murrayinglis/EEE4113F-Group19/Housing/Pictures/Final Design in E drawing exploded View.png

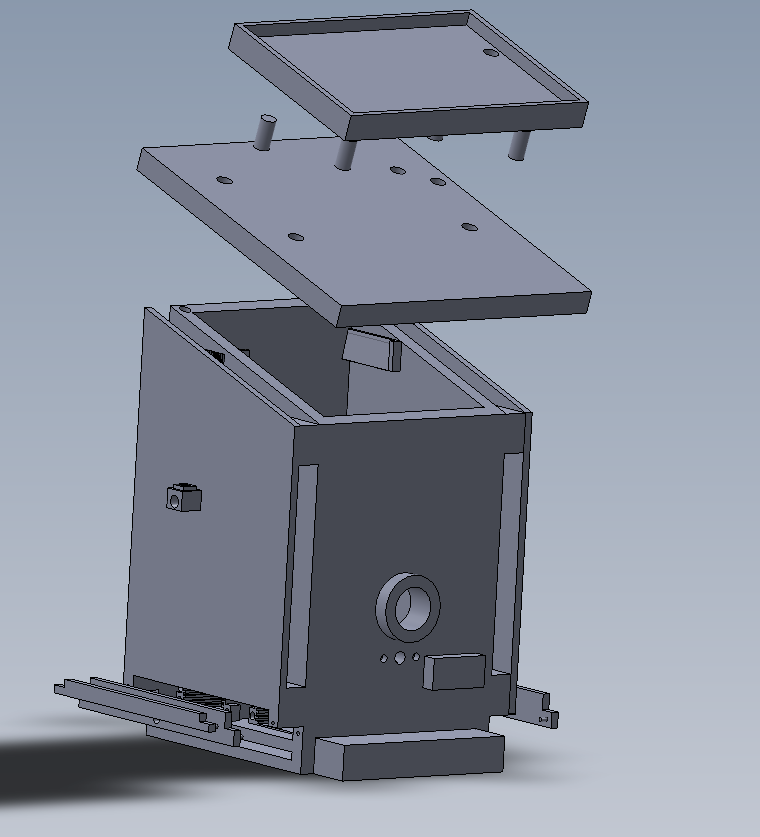
Housing/Pictures/Final Design in E drawing exploded View.png
