murrayinglis/EEE4113F-Group19/Housing/Pictures/Final Design/20240512_164723.jpg

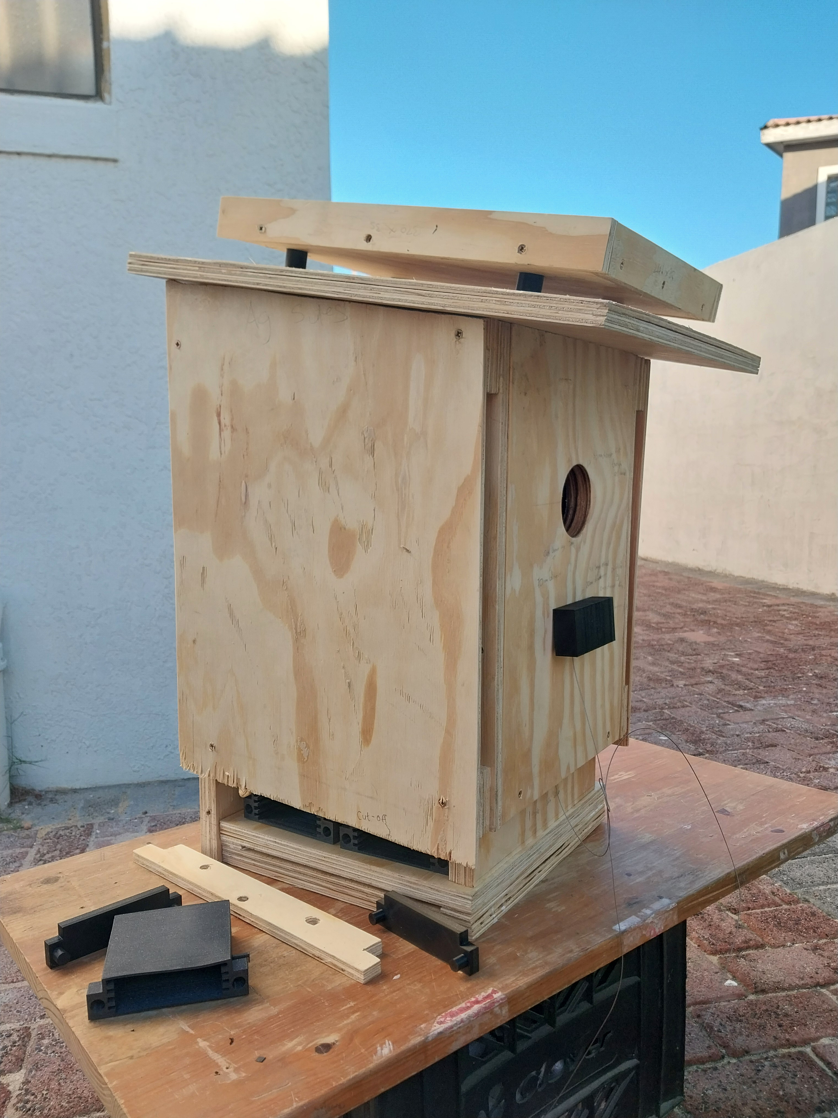
Housing/Pictures/Final Design/20240512_164723.jpg
