murrayinglis/EEE4113F-Group19/README.md

# EEE4113F Group 19 Project
This project concerns the development of a temperature sensing system. There are 4 subsystems: Power, GUI, Sensing and Housing. This repository contains the resources used to complete the project.
