murrayinglis/EEE4113F-Group19/Docs/Requirements Specifications.docx

Requirements:

Microcontroller + sensing:

Power:

Physical design:


UI:
