murrayinglis/EEE4113F-Group19/Docs/Lit Review Sources.docx

Lit Review Sources

https://open.uct.ac.za/server/api/core/bitstreams/53c4703e-6efa-4478-9e95-13aa0d085189/content

High Ta during the nesting period had a negative effect on the outcomes of hornbill breeding attempts. Page 85

https://www.researchgate.net/profile/Soon-Chye-Ng/publication/242690746_Infanticide-cannibalism_in_the_Oriental_Pied_Hornbill_Anthracoceros_albirostris/links/0046353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

infanticide-cannibalism

https://link.springer.com/article/10.1186/s40317-015-0075-2

Rectal or cloacal temperature is commonly measured using thermometry

https://www-ncbi-nlm-nih-gov.ezproxy.uct.ac.za/pmc/articles/PMC5723608/

Our search of 18 years of literature (1998–2015) in 20 target ecology journals identified a total of 185 papers that used iButtons

https://onlinelibrary-wiley-com.ezproxy.uct.ac.za/doi/full/10.1111/ibi.12010

Thermal imaging can be a valuable tool to examine energy expenditure

As yet, this technique has not been widely used

https://www-ncbi-nlm-nih-gov.ezproxy.uct.ac.za/pmc/articles/PMC6476170/

we experienced a 65% failure rate of iButton Hygrochrons after a one‐year deployment

comms stuff:

https://www-sciencedirect-com.ezproxy.uct.ac.za/science/article/pii/S095741742303364X?via%3Dihub

Communication between the smart node in our project and the IoT is established via Cytron 915 MHz LoRa RFM shield, which allows data to be wirelessly transmitted over a long distance at low data rates (<50 kbps)

https://www-sciencedirect-com.ezproxy.uct.ac.za/science/article/pii/S0957417422019947?via%3Dihub

https://ieeexplore-ieee-org.ezproxy.uct.ac.za/document/1367928

https://www-sciencedirect-com.ezproxy.uct.ac.za/science/article/pii/S0165027019301037?via%3Dihub
