murrayinglis/EEE4113F-Group19/Docs/lorawan.jpg

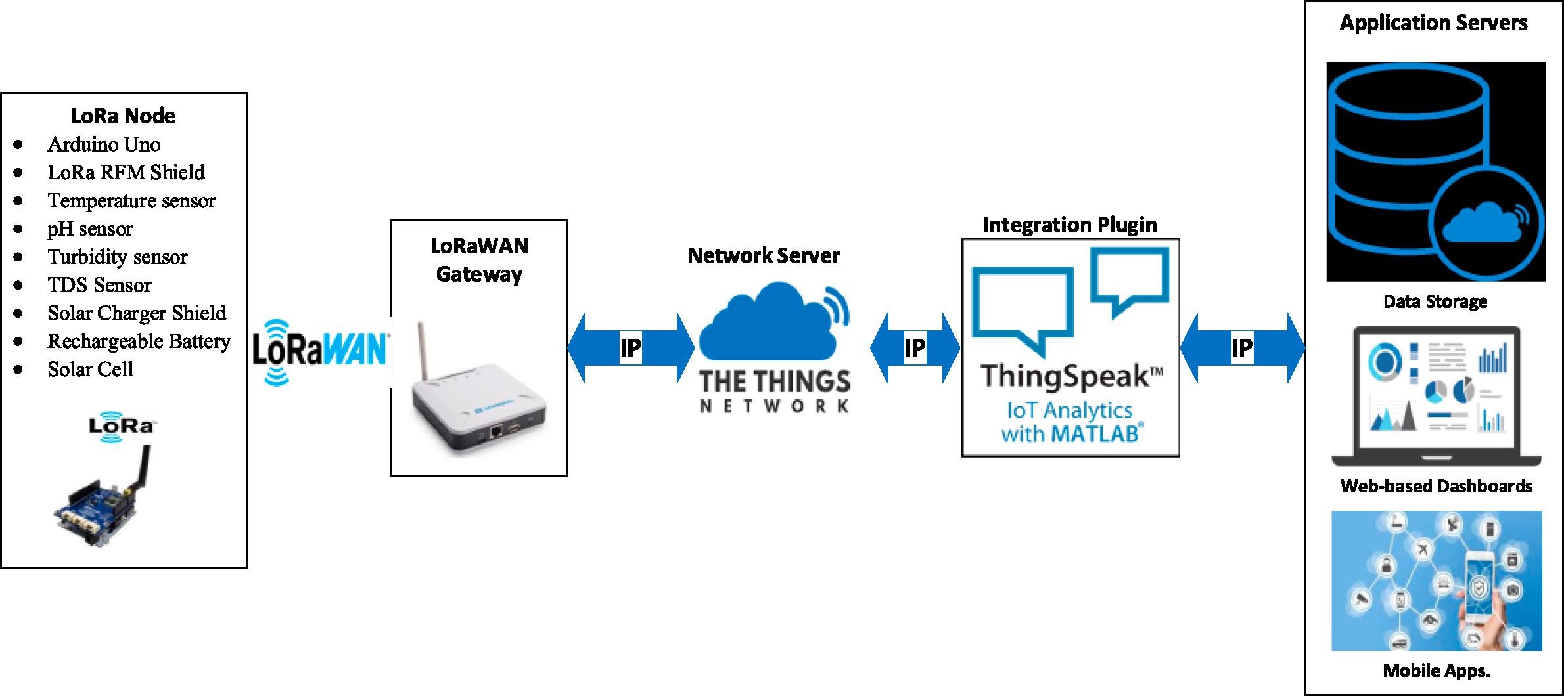
Docs/lorawan.jpg
