murrayinglis/EEE4113F-Group19/Figures/antenna.png

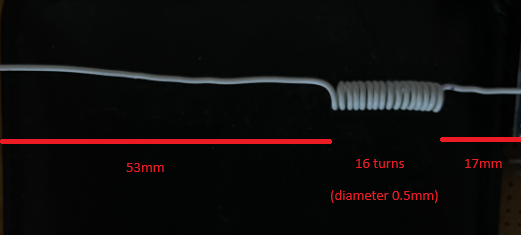
Figures/antenna.png
