murrayinglis/EEE4113F-Group19/Figures/ds18b20.png

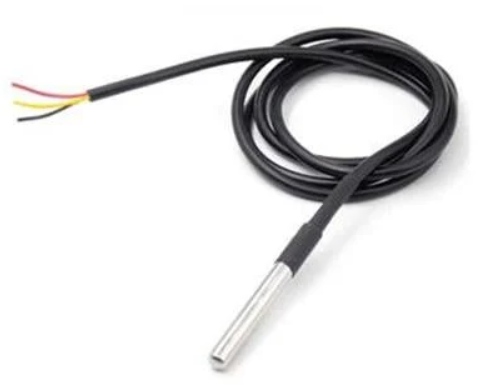
Figures/ds18b20.png
