murrayinglis/EEE4113F-Group19/Figures/receiver.drawio.png

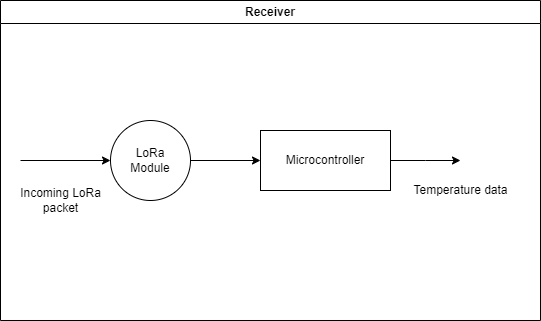
Figures/receiver.drawio.png
