murrayinglis/EEE4113F-Group19/Figures/receiver.png

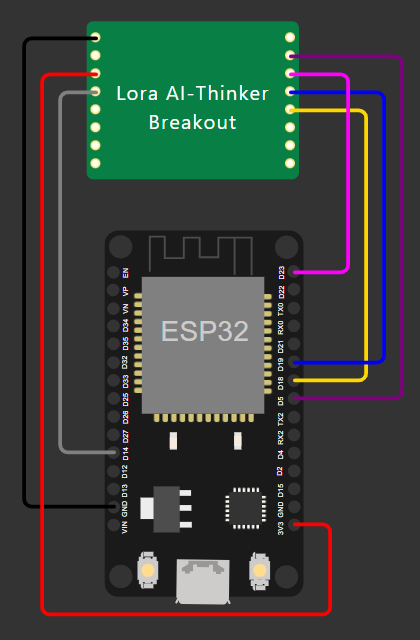
Figures/receiver.png
