murrayinglis/EEE4113F-Group19/Figures/receiver_veroboard.png

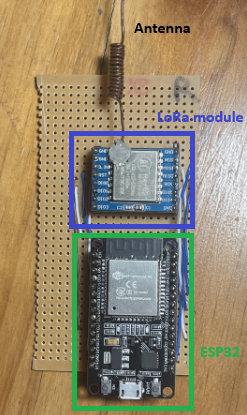
Figures/receiver_veroboard.png
