murrayinglis/EEE4113F-Group19/Figures/state_machine.drawio.png

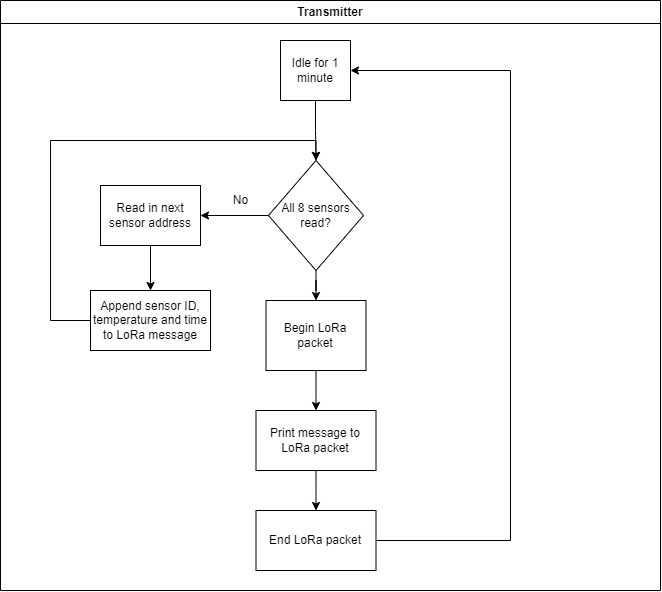
Figures/state_machine.drawio.png
