murrayinglis/EEE4113F-Group19/Figures/transmitter.png

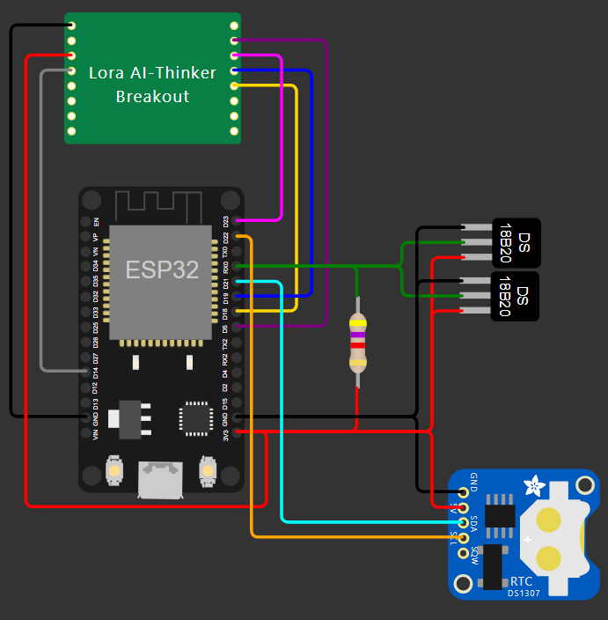
Figures/transmitter.png
