murrayinglis/EEE4113F-Group19/Figures/transmitter_veroboard.png

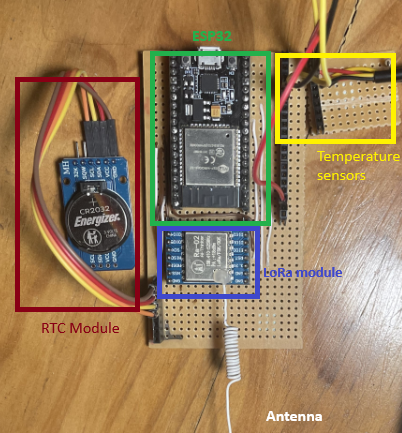
Figures/transmitter_veroboard.png
