murrayinglis/EEE4113F-Group19/Figures/trasnmitter.drawio.png

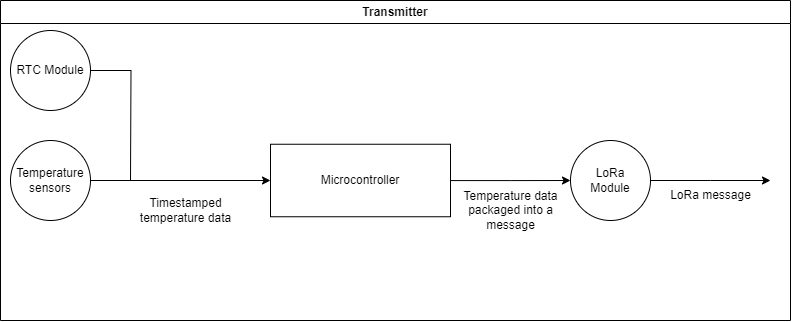
Figures/trasnmitter.drawio.png
