murrayinglis/EEE4113F-Group19/Housing/Pictures/Air gap increasing distance.png

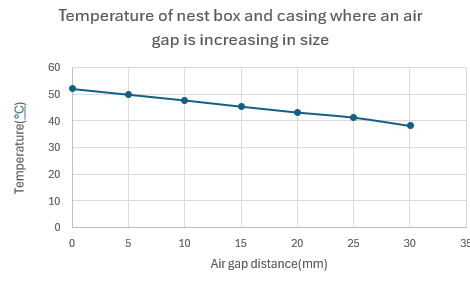
Housing/Pictures/Air gap increasing distance.png
