murrayinglis/EEE4113F-Group19/Housing/Pictures/Design box .png

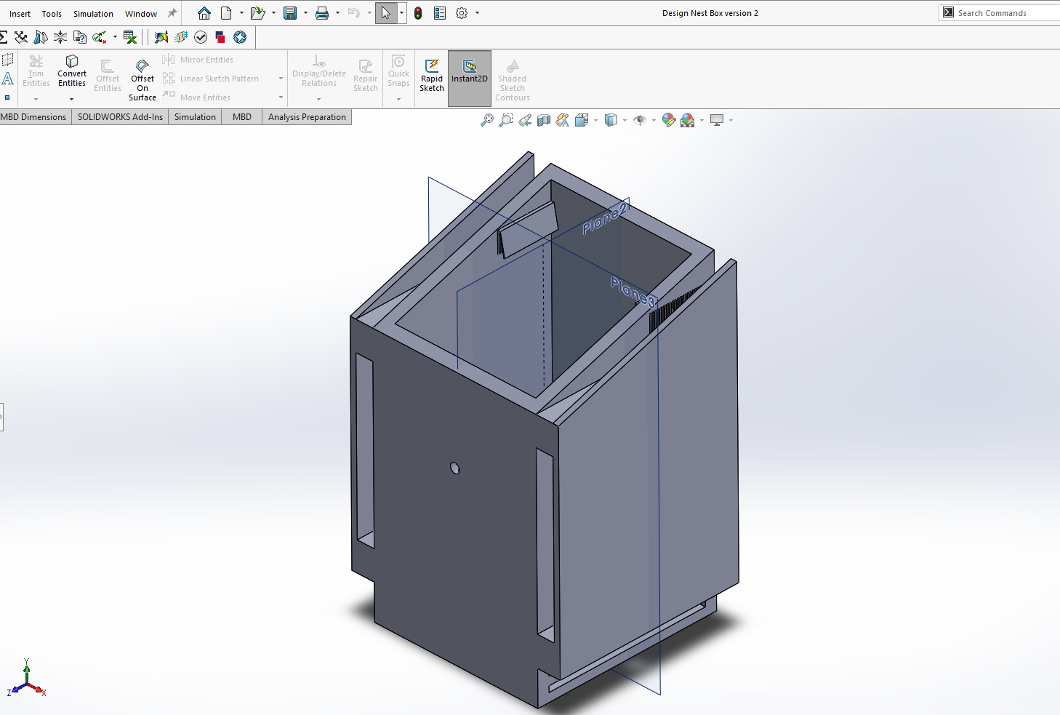
Housing/Pictures/Design box .png
