murrayinglis/EEE4113F-Group19/Housing/Pictures/Design box side profile.png

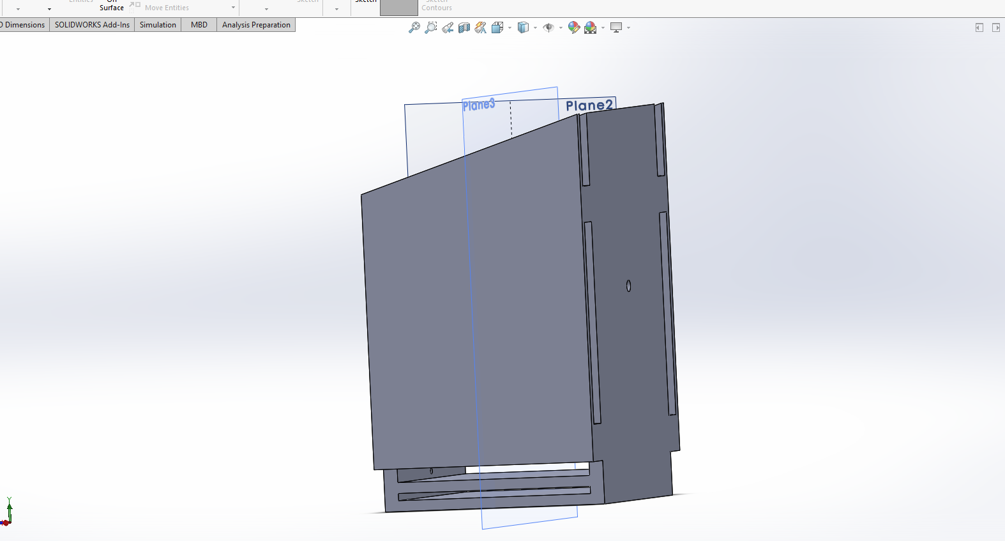
Housing/Pictures/Design box side profile.png
