murrayinglis/EEE4113F-Group19/Housing/Pictures/Diameter graph.png

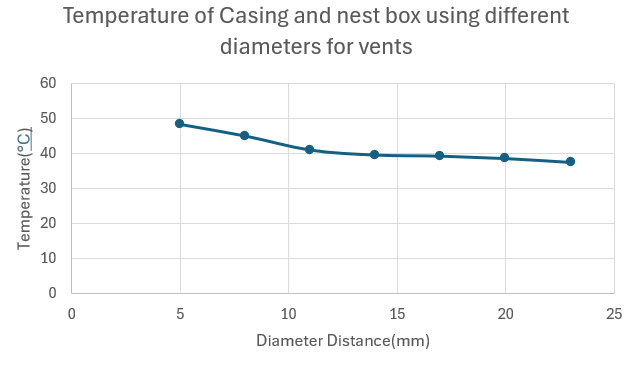
Housing/Pictures/Diameter graph.png
