murrayinglis/EEE4113F-Group19/Housing/Pictures/Displacement.png

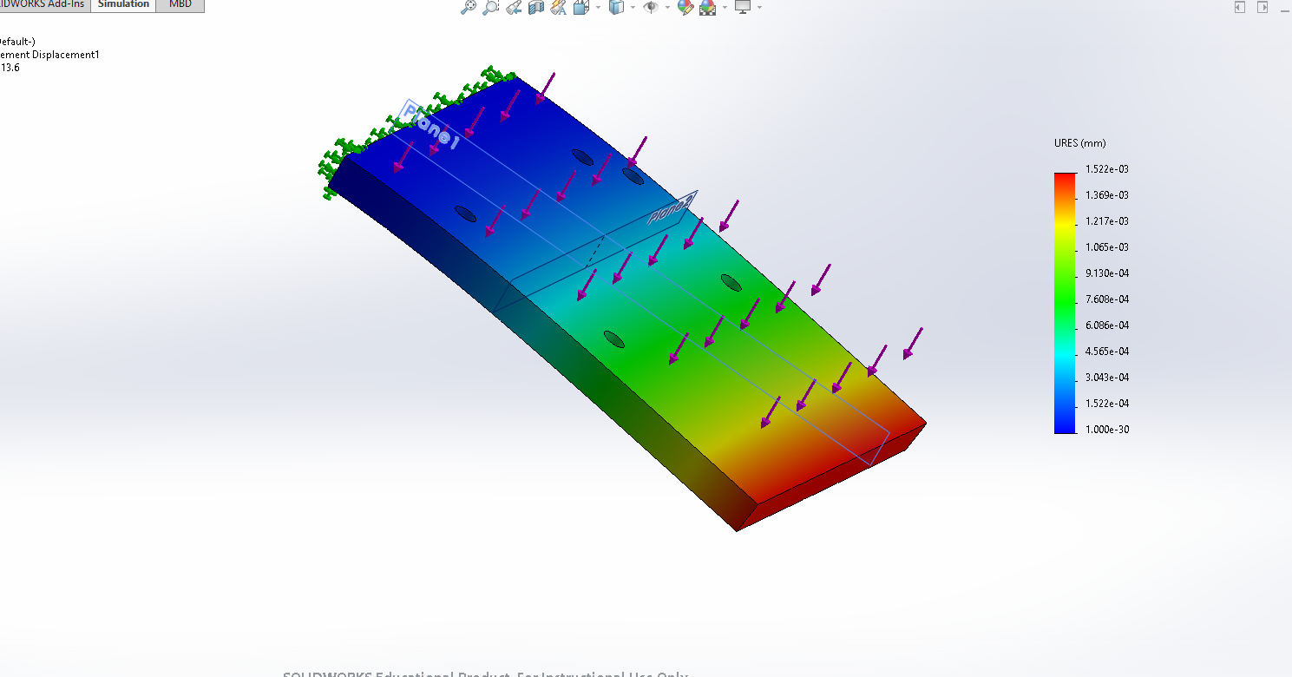
Housing/Pictures/Displacement.png
