murrayinglis/EEE4113F-Group19/Housing/Pictures/Drawing of Tepreture sensor holder.png

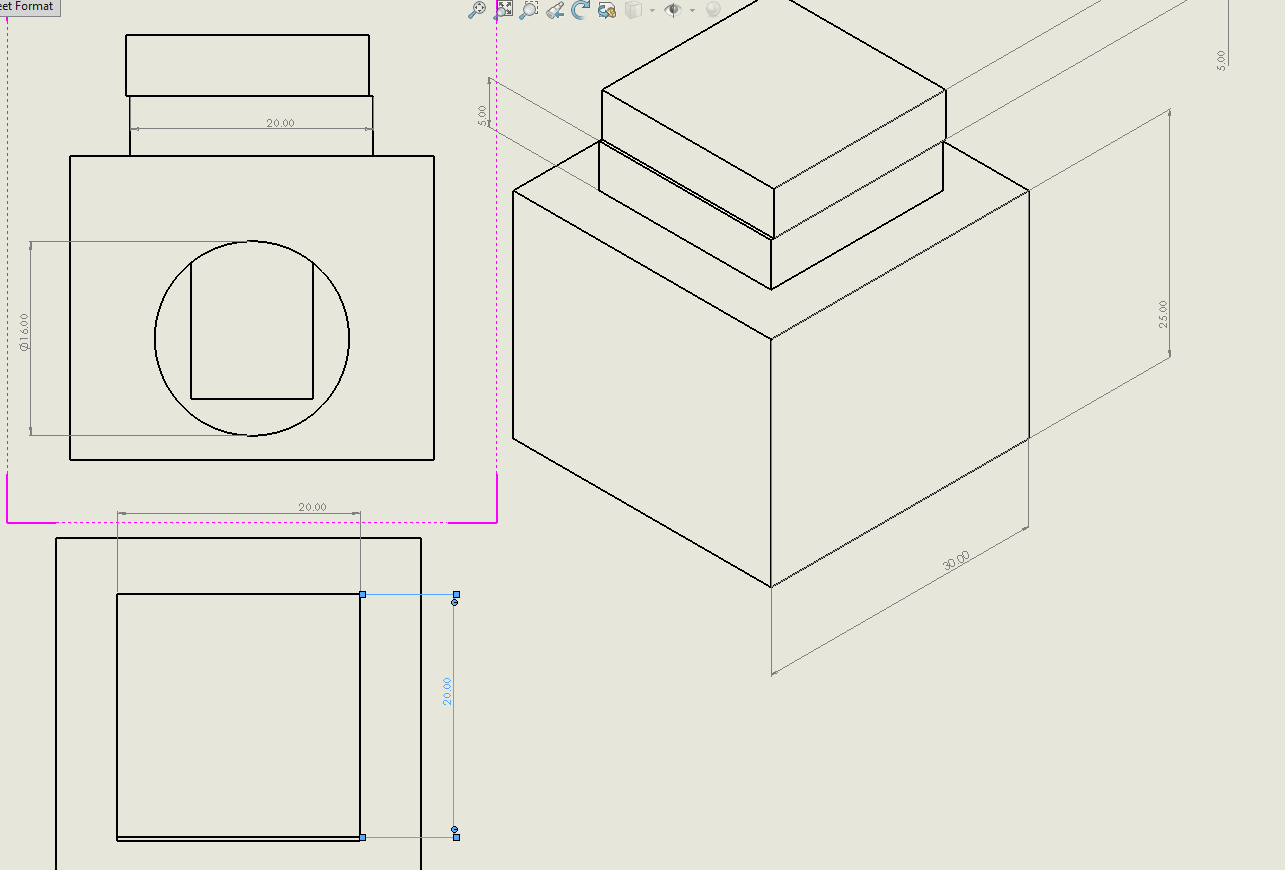
Housing/Pictures/Drawing of Tepreture sensor holder.png
