murrayinglis/EEE4113F-Group19/Housing/Pictures/Drawings for Enclosure Box.png

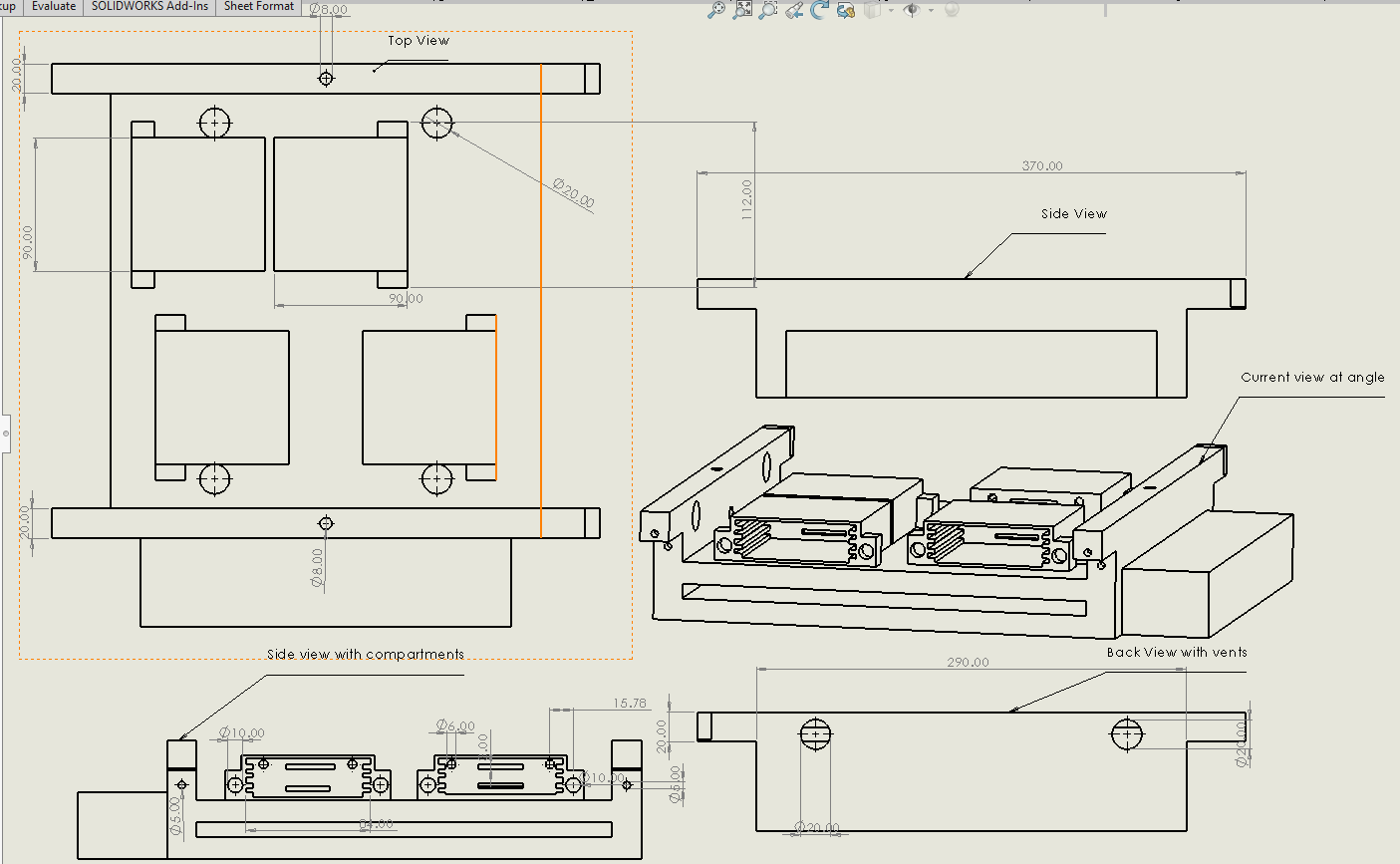
Housing/Pictures/Drawings for Enclosure Box.png
