murrayinglis/EEE4113F-Group19/Housing/Pictures/Electronics Compartment with another air gap for thermal mass below it.png

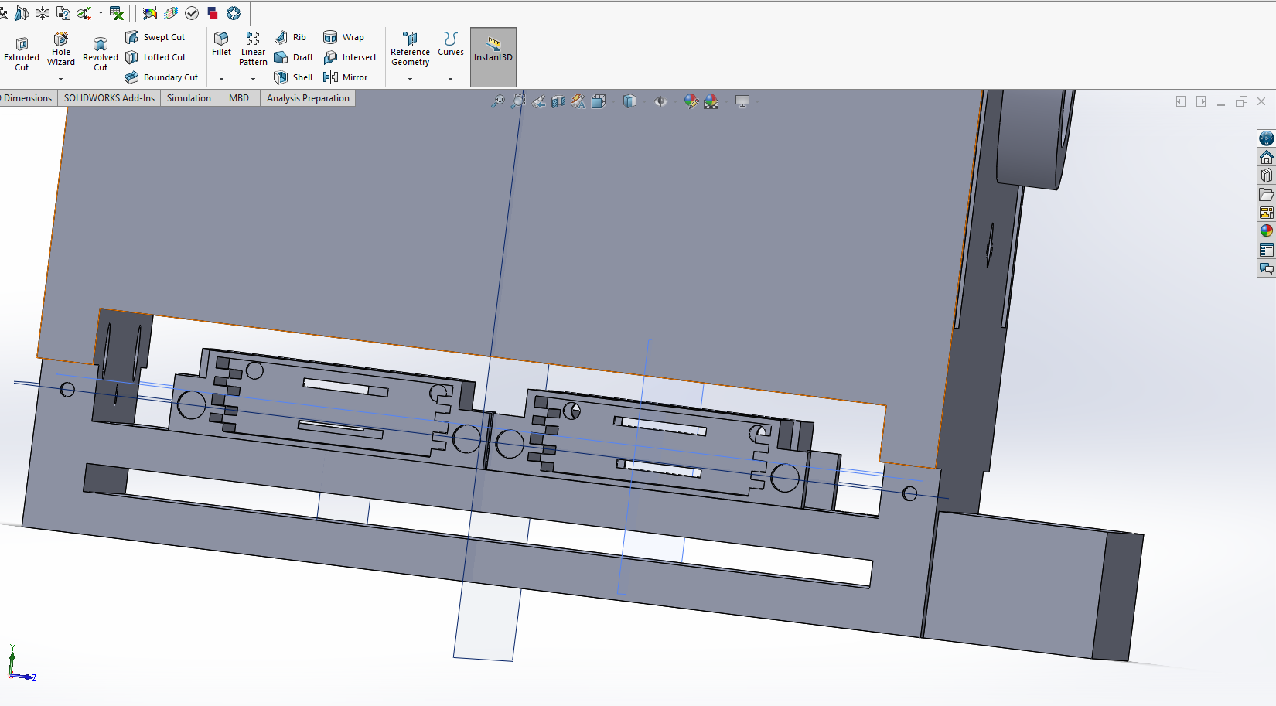
Housing/Pictures/Electronics Compartment with another air gap for thermal mass below it.png
