murrayinglis/EEE4113F-Group19/Housing/Pictures/Enclosure section viewed.png

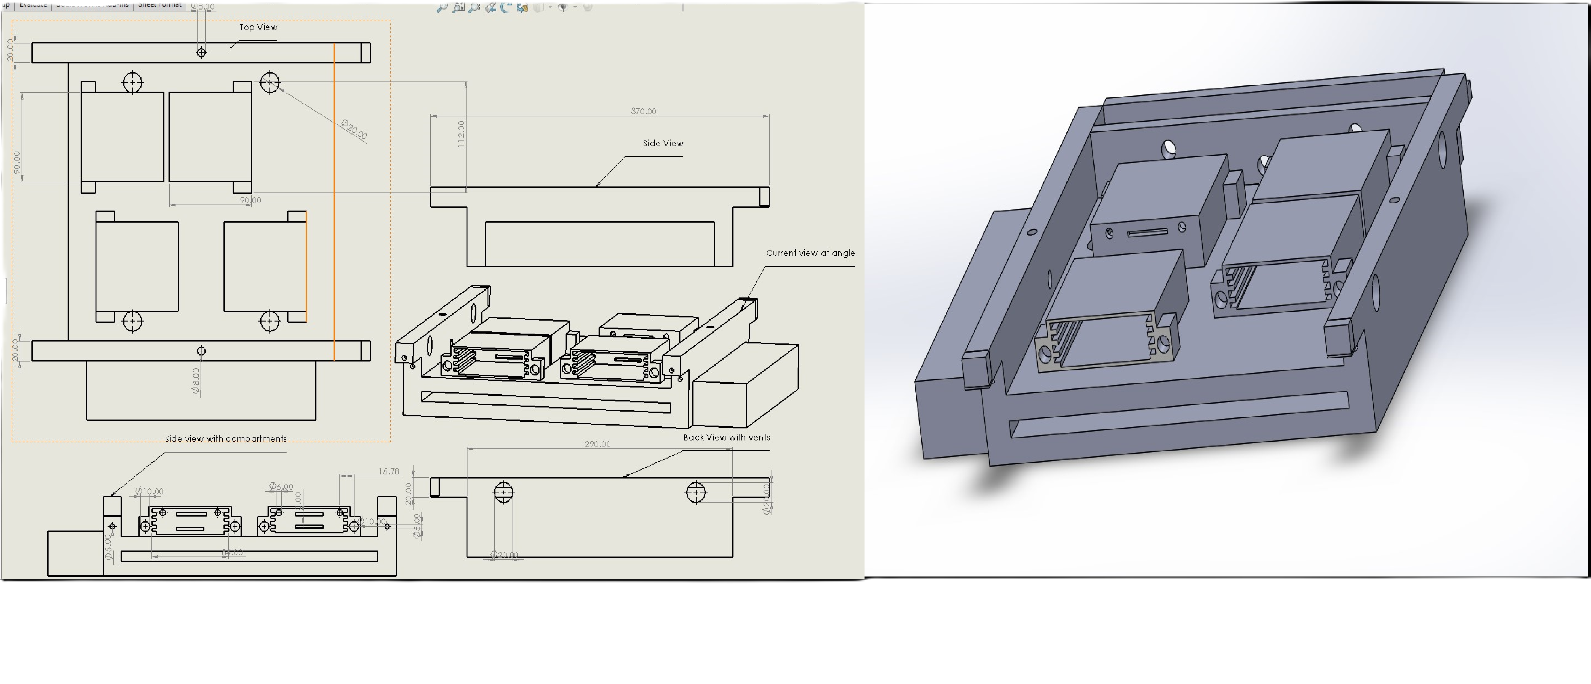
Housing/Pictures/Enclosure section viewed.png
