murrayinglis/EEE4113F-Group19/Housing/Pictures/Exploded View/Screenshot_20240511_043744_Samsung Notes.jpg

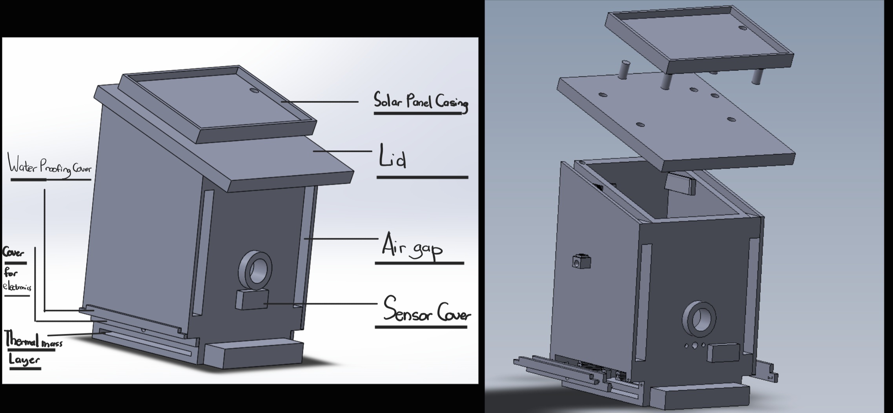
Housing/Pictures/Exploded View/Screenshot_20240511_043744_Samsung Notes.jpg
