murrayinglis/EEE4113F-Group19/Housing/Pictures/Exploded View/Screenshot_20240511_044054_Samsung Notes.jpg

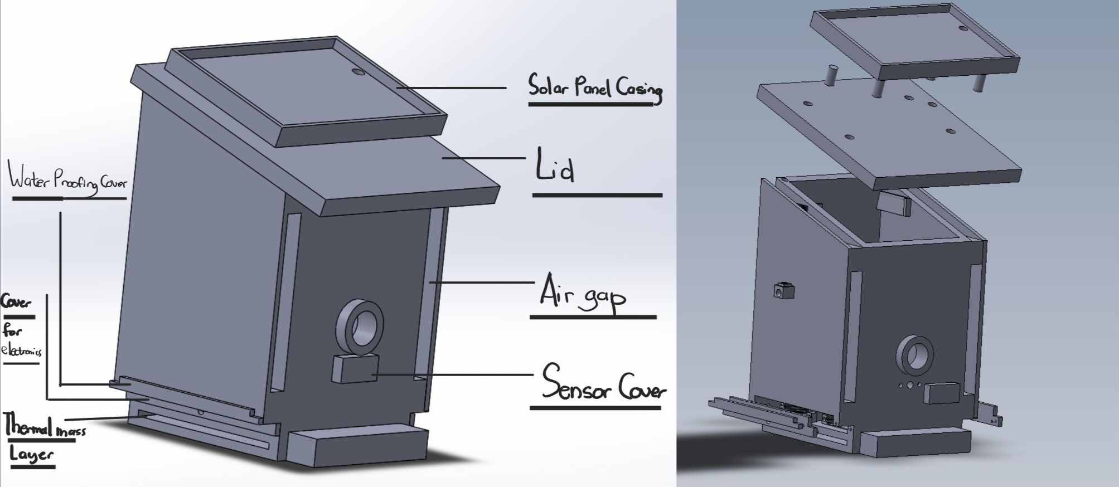
Housing/Pictures/Exploded View/Screenshot_20240511_044054_Samsung Notes.jpg
