murrayinglis/EEE4113F-Group19/Housing/Pictures/Extra coverings and Temp sensor casings.png

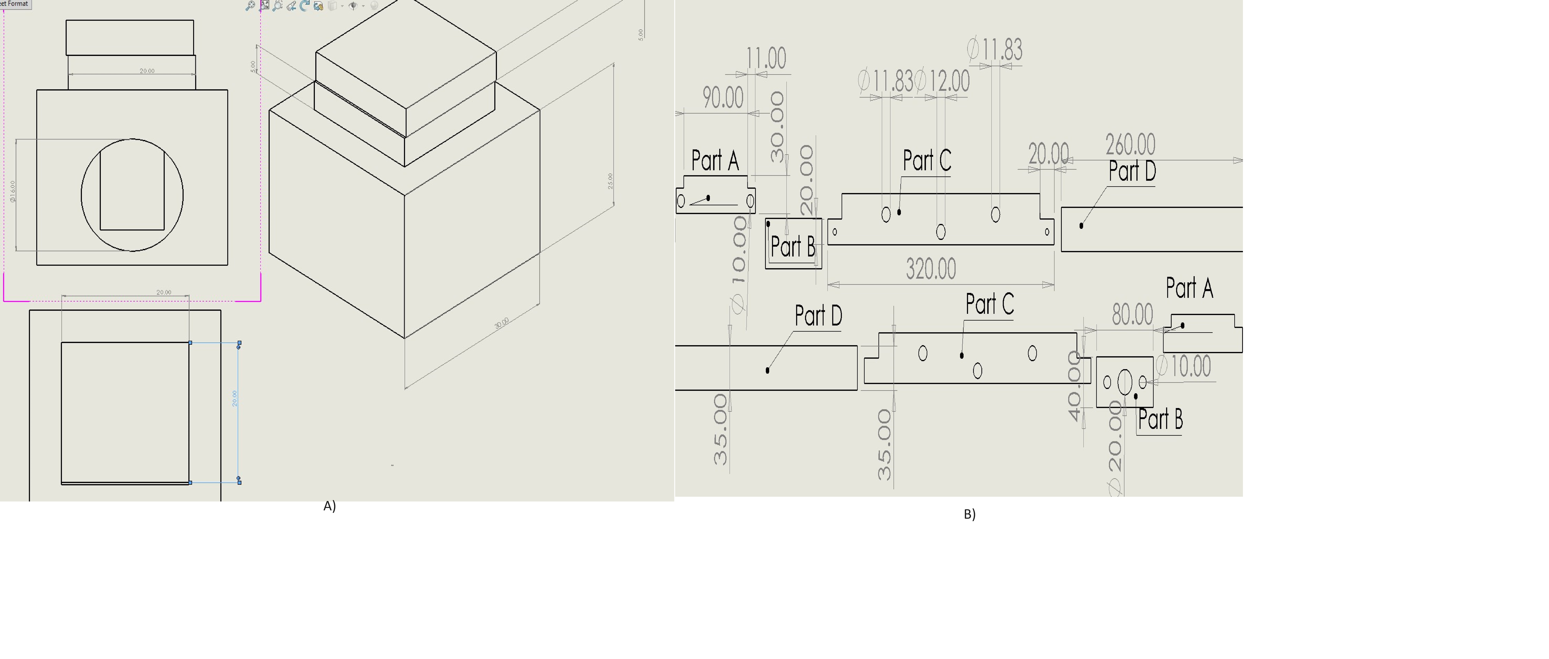
Housing/Pictures/Extra coverings and Temp sensor casings.png
