murrayinglis/EEE4113F-Group19/Housing/Pictures/Final Design of Nest box .png

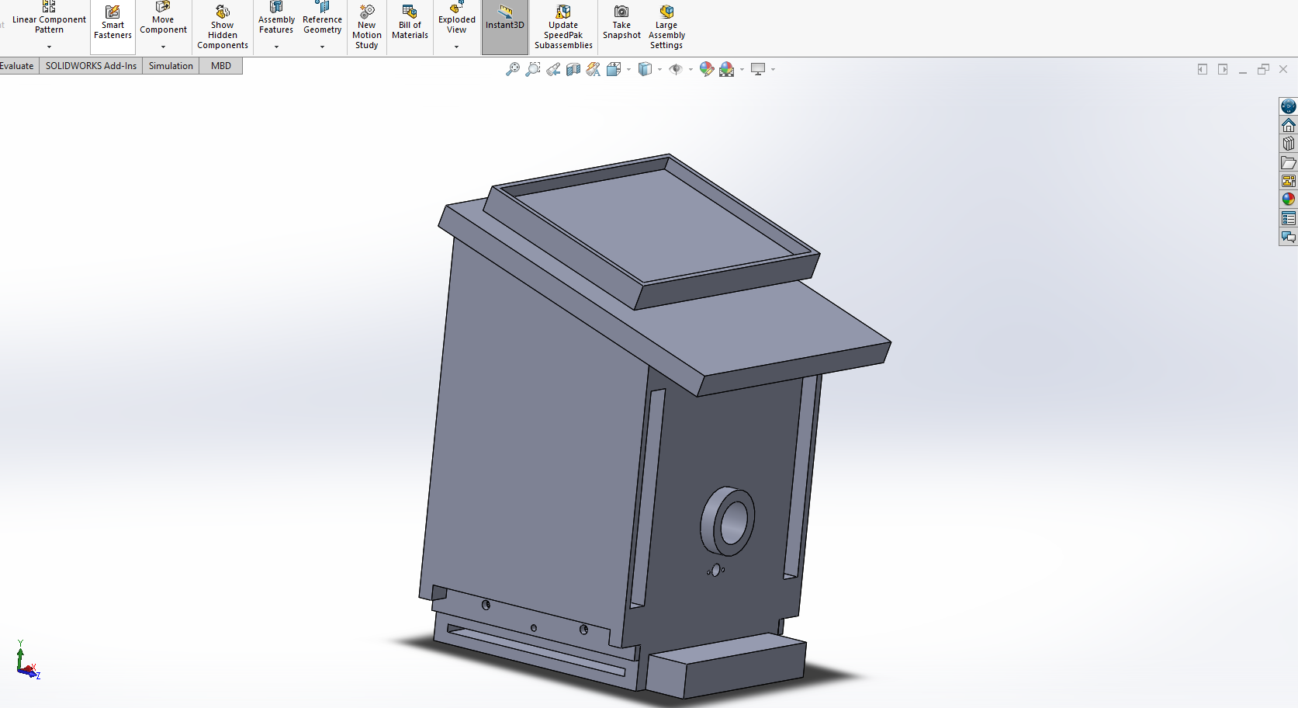
Housing/Pictures/Final Design of Nest box .png
