murrayinglis/EEE4113F-Group19/Housing/Pictures/Final final Design of nest box.png

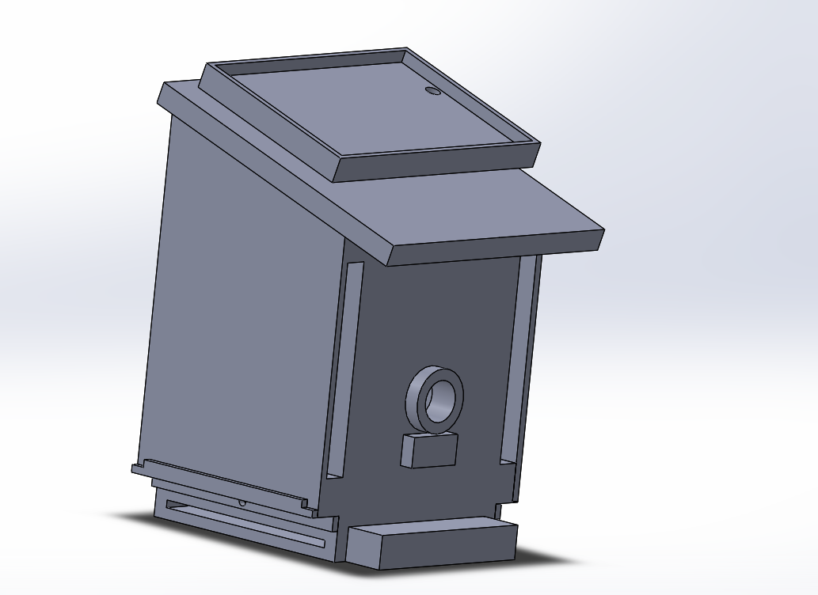
Housing/Pictures/Final final Design of nest box.png
