murrayinglis/EEE4113F-Group19/Housing/Pictures/Final temp lid and coverings.png

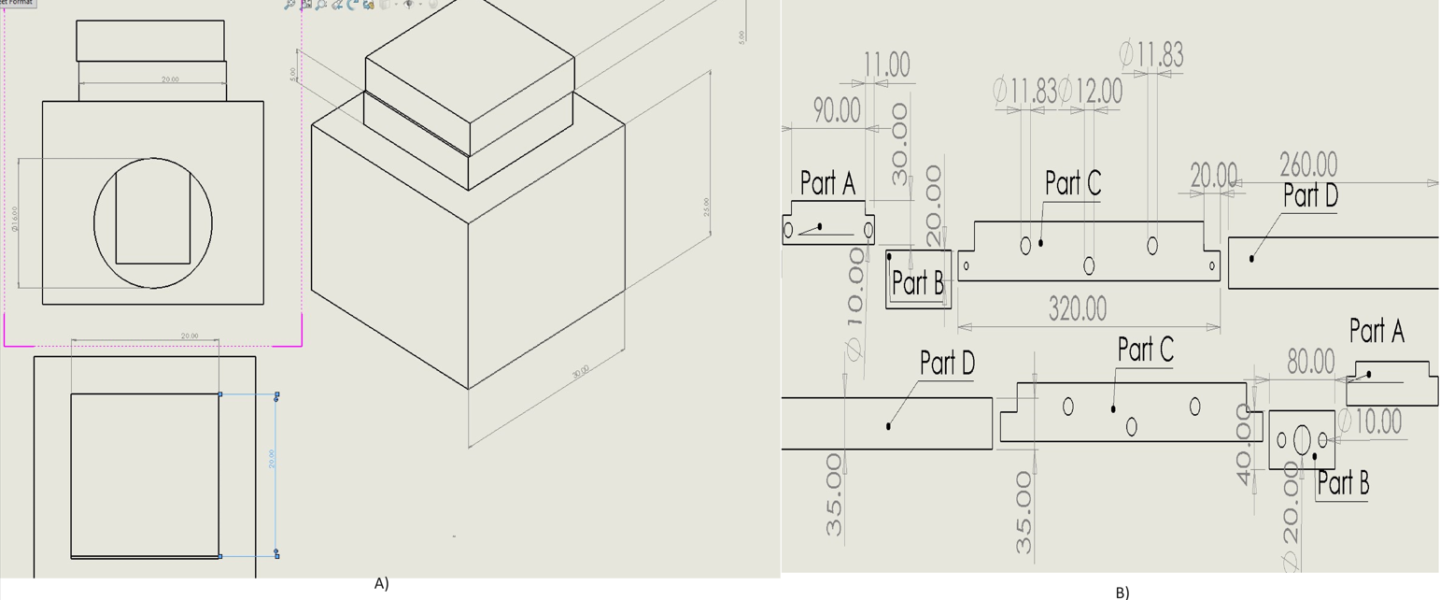
Housing/Pictures/Final temp lid and coverings.png
