murrayinglis/EEE4113F-Group19/Housing/Pictures/Housing of Electrical compartments.png

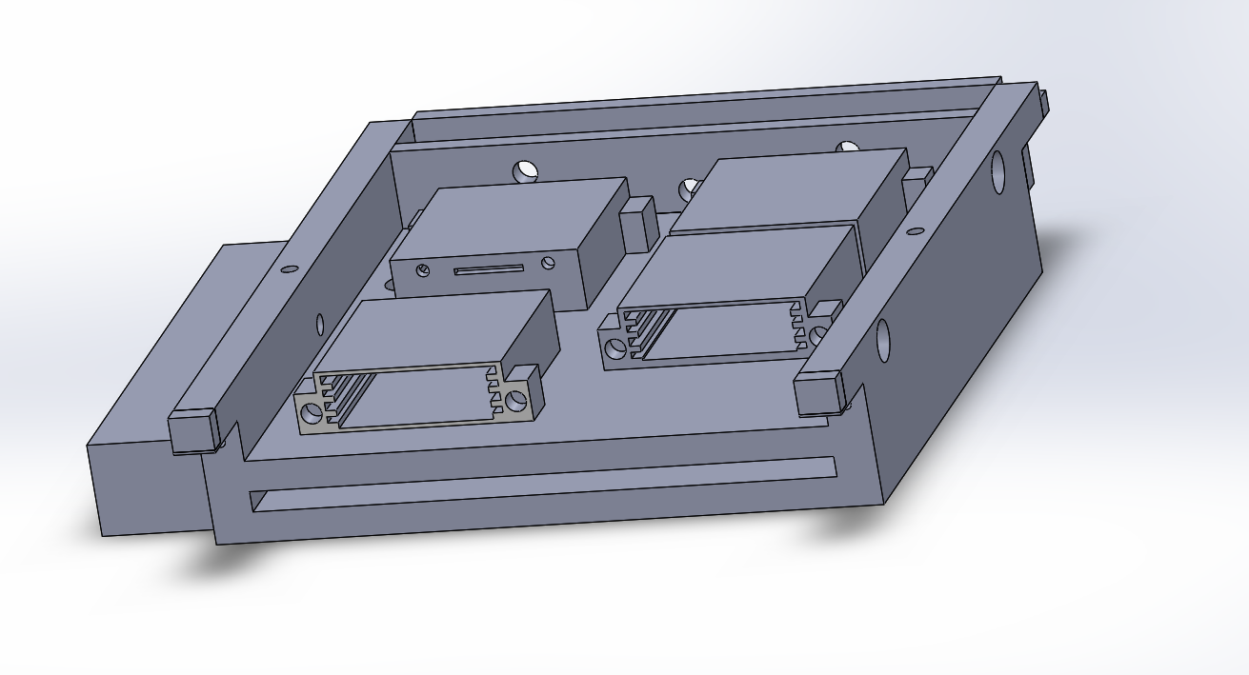
Housing/Pictures/Housing of Electrical compartments.png
