murrayinglis/EEE4113F-Group19/Housing/Pictures/Lid and Enclosure stress analysis.jpg

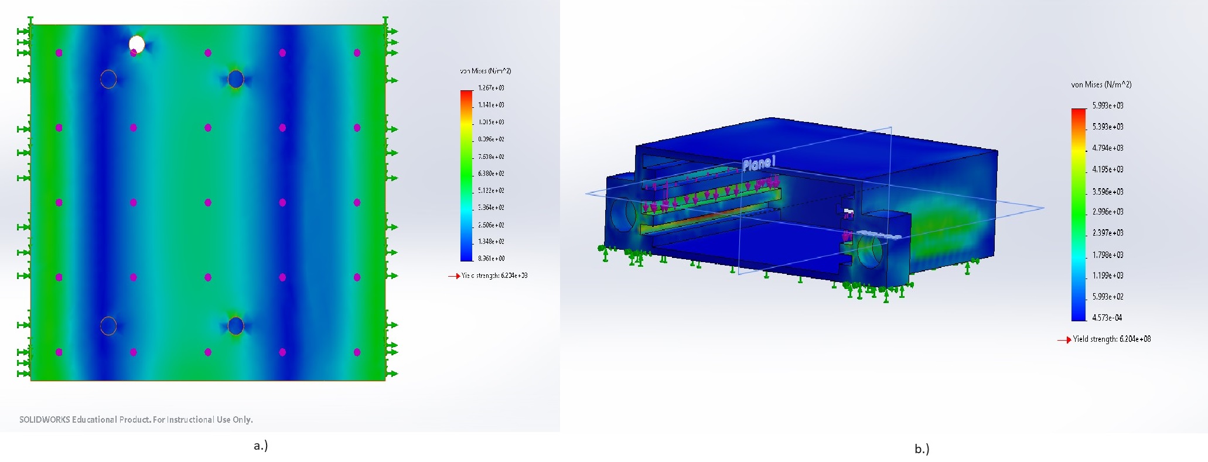
Housing/Pictures/Lid and Enclosure stress analysis.jpg
