murrayinglis/EEE4113F-Group19/Housing/Pictures/Lid stress analysis.png

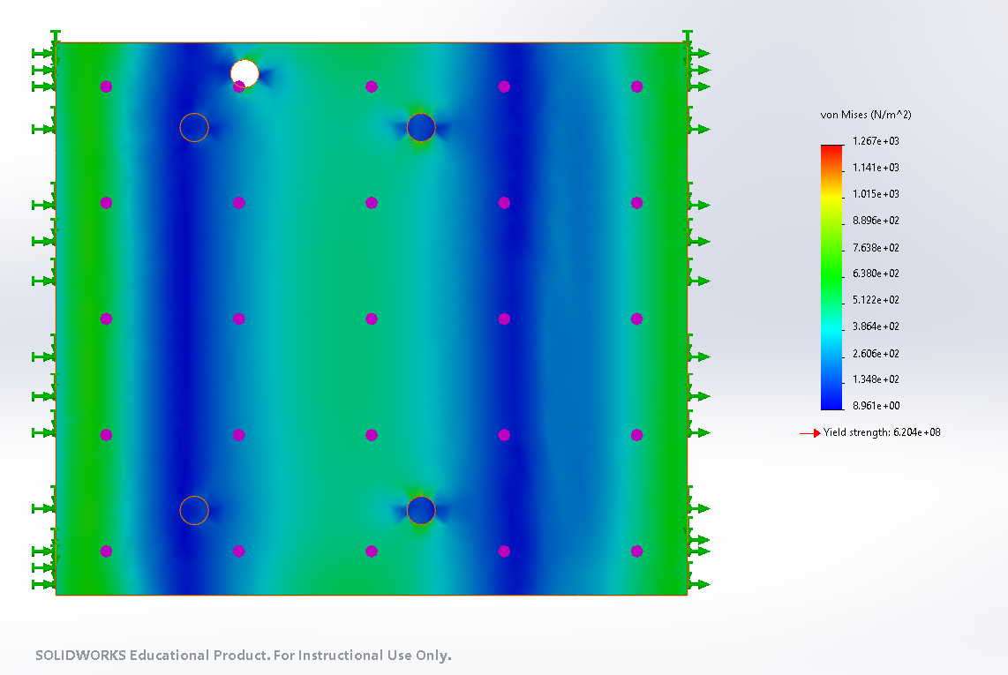
Housing/Pictures/Lid stress analysis.png
