murrayinglis/EEE4113F-Group19/Housing/Pictures/Screenshot 2024-03-16 092010.png

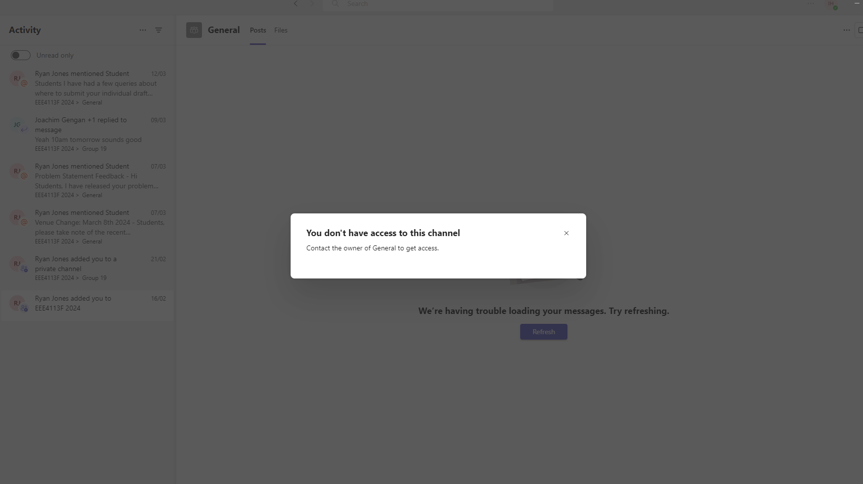
Housing/Pictures/Screenshot 2024-03-16 092010.png
