murrayinglis/EEE4113F-Group19/Housing/Pictures/Screenshot_20240511_044622_Samsung Notes.jpg

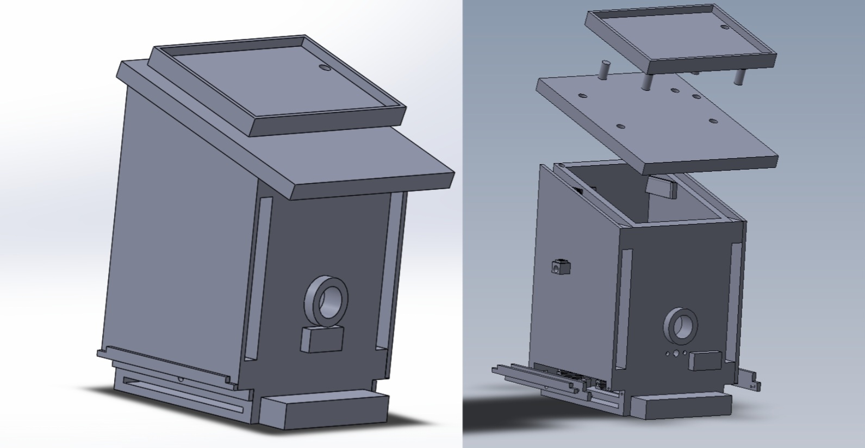
Housing/Pictures/Screenshot_20240511_044622_Samsung Notes.jpg
