murrayinglis/EEE4113F-Group19/Housing/Pictures/Signature .jpg

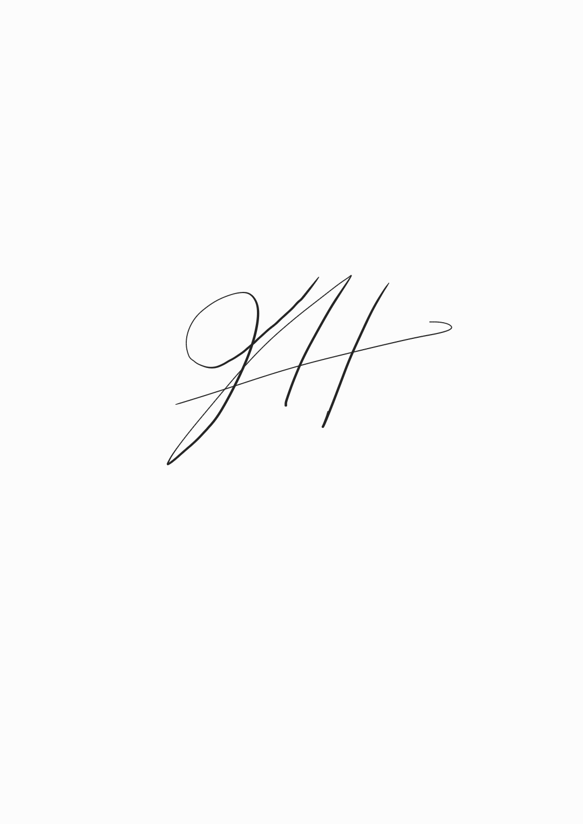
Housing/Pictures/Signature .jpg
