murrayinglis/EEE4113F-Group19/Housing/Pictures/Stess analysis on Elecrrical Compartment.png

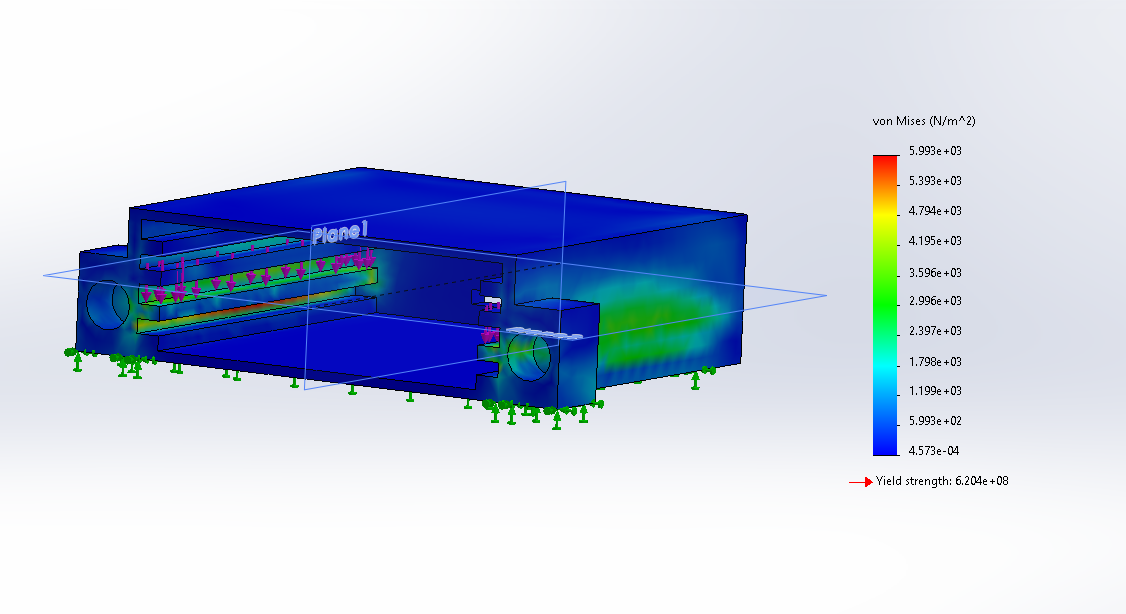
Housing/Pictures/Stess analysis on Elecrrical Compartment.png
