murrayinglis/EEE4113F-Group19/Housing/Pictures/Strain.png

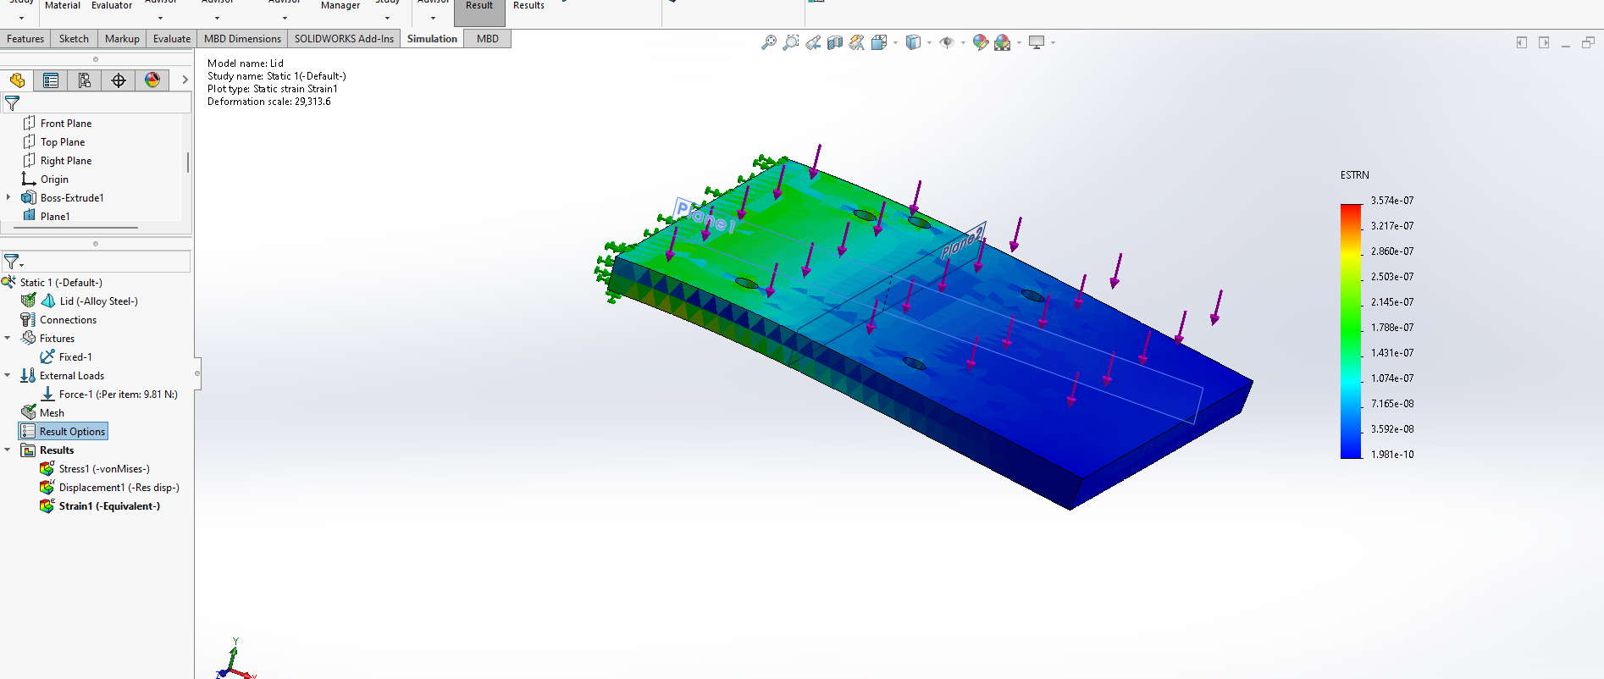
Housing/Pictures/Strain.png
