murrayinglis/EEE4113F-Group19/Housing/Pictures/Stress analysis on Temp Sensor Casing.png

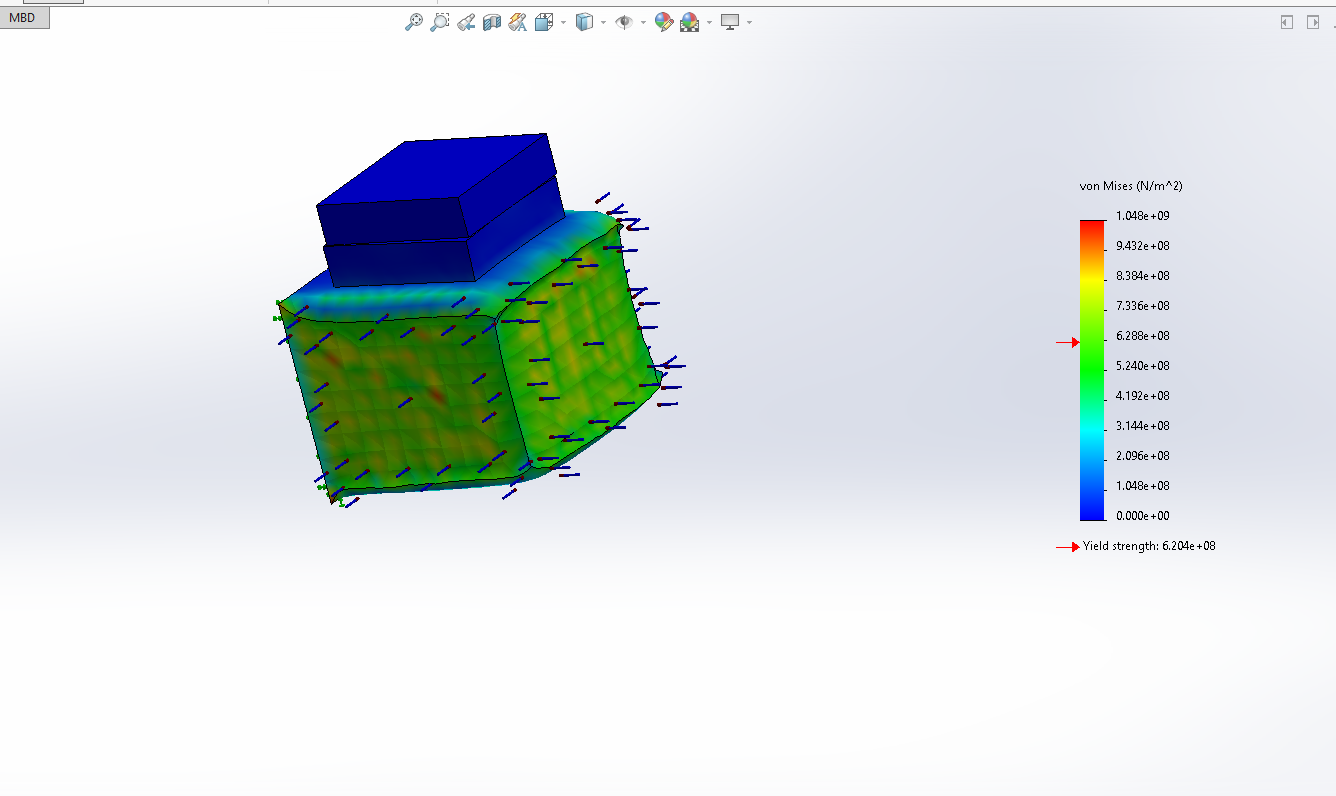
Housing/Pictures/Stress analysis on Temp Sensor Casing.png
