murrayinglis/EEE4113F-Group19/Housing/Pictures/Stress analysis.png

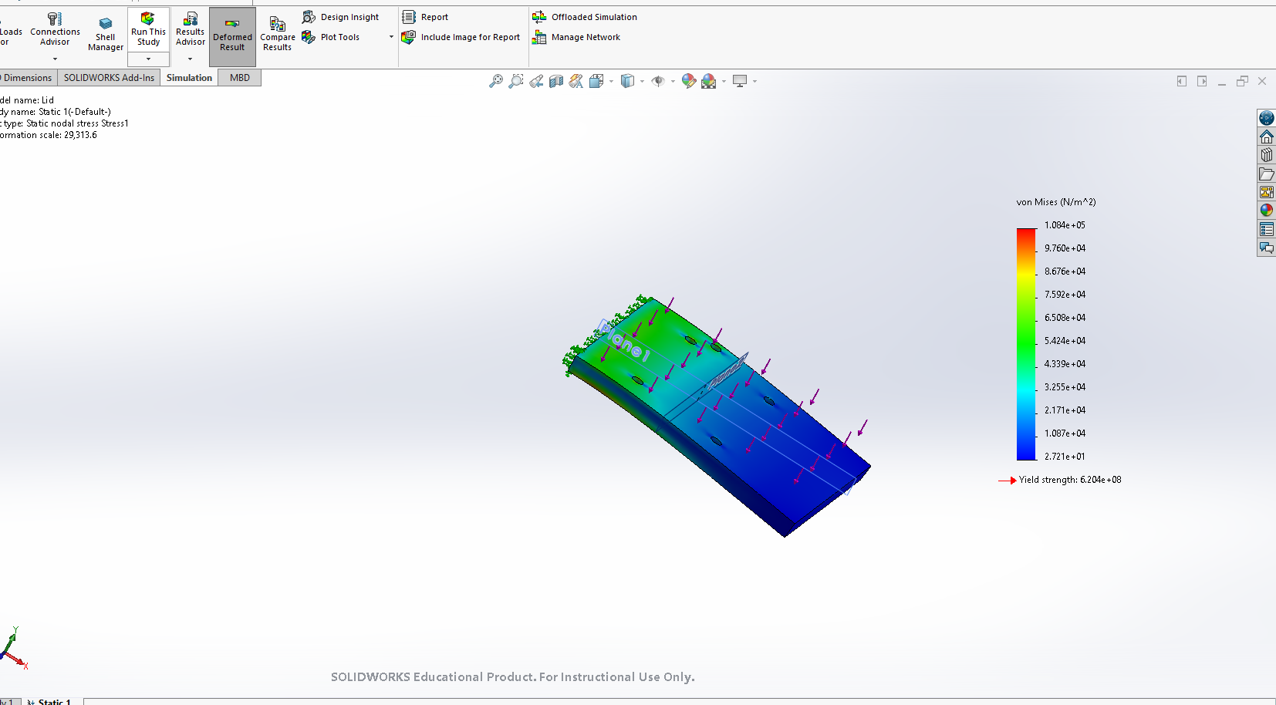
Housing/Pictures/Stress analysis.png
