murrayinglis/EEE4113F-Group19/Housing/Pictures/Temperature of Nest Box and housing wrt wood thickness.png

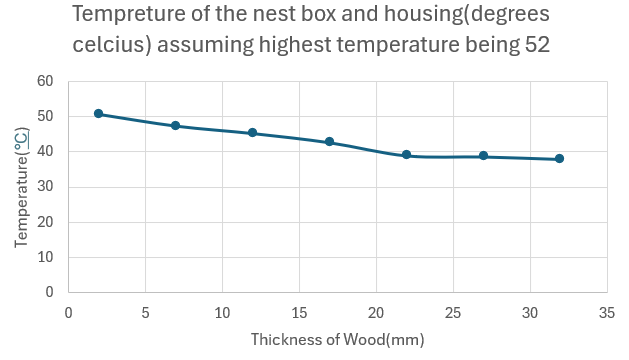
Housing/Pictures/Temperature of Nest Box and housing wrt wood thickness.png
