murrayinglis/EEE4113F-Group19/Housing/Pictures/Thermal mass layer.png

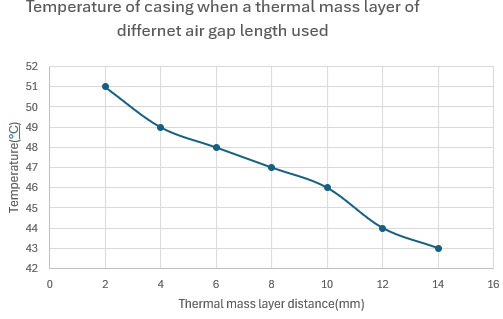
Housing/Pictures/Thermal mass layer.png
