murrayinglis/EEE4113F-Group19/EEE4113F_BOM_GROUP19 (1).xlsx

Sheet: User Interface
Item Common Name | Part number | Supplier | Unit Price (F1ZAR) [1] - Please include VAT | QTY Required | Combined Price | Online Link of item
MicroSD card module | 9SDMODMICRO | DIY Electronics | R 39.95 | 1 | 39.95 | https://www.diyelectronics.co.za/store/memory/512-micro-sd-card-module.html
SanDisk Ultra 32GB MicroSDHC Class 10 UHS-I Memory Card |  | Takealot | R89.00 | 1 | 89 | https://www.takealot.com/sandisk-ultra-32gb-microsdhc-class-10-uhs-i-memory-card/PLID71224424
 |  |  |  |  | TOTAL
 |  |  |  |  | 128.95

Sheet: Housing
Item Common Name | Part number | Supplier | Unit Price (F1ZAR) [1] - Please include VAT | QTY Required | Combined Price
6mm Plywood |  | Buco | R364 | 1 | 364
hinge |  | Buco | R35 | 1 | 35
nails |  | Buco | R30 | 1 | 30
 |  |  |  | TOTAL | 429

Sheet: Sensing
Item Common Name | Part number | Supplier | Unit Price (F1ZAR) [1] - Please include VAT | QTY Required | Combined Price | Online Link of item
LoRa module | RA-01H 868Mhz SX1278 | Micro Robotics | R 135.70 | 2 | 271.4 | https://www.robotics.org.za/RA-01H
ESP32 dev board | HKD ESP-32 WIFI B/T DEV BOARD | Communica | R 159.00 | 2 | 318 | https://www.communica.co.za/products/hkd-esp-32-wifi-b-t-dev-board
Temperature sensor | HKD TEMPERATURE PROBE DS18B20 1M | Communica | R27.00 | 7 | 78 | https://www.communica.co.za/products/hkd-temperature-probe-ds18b20-1m?variant=39363819536457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
RTC Module | HKD REAL TIME CLOCK-DS1302 | Communica | R20 | 3 | 60
 |  |  |  |  | Total
 |  |  |  |  | 727.4

Sheet: Power
Manufacturer/ Order Location | Component | Name Part | Link | Price incl. VAT | QTY | Price
Solar Charger BOM
Communica | D6 | 1N4148 Rectifier Diode | https://www.communica.co.za/products/1n4148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 | R0,46 | 1 | R0,46
Communica | R2, R7, R8, R9, R1, R3, R5 | 10k ohm resistor | https://www.communica.co.za/products/cfr25j-10k?variant=30986617225289 | R1,32 | 9 | R11,88
Communica | D7 | 1N4007 Rectifier Diode | https://www.communica.co.za/products/1n4004f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 | R0,58 | 1 | R0,58
Communica | D3 | Red LED | https://www.communica.co.za/products/l-53id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 | R1,96 | 2 | R3,92
Communica | R4, R12 | 4.7k ohm resistor | https://www.communica.co.za/products/cfr25j-4k7?variant=31152277553225 | R0,16 | 2 | R0,32
Communica | R6 | 1k ohm resistor | https://www.communica.co.za/products/cfr50j-1k0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 | R0,35 | 1 | R0,35
Communica | R11 | 3.9k ohm resistor | https://www.communica.co.za/products/cfr25j-39k?variant=31232758775881 | R0,16 | 1 | R0,16
Communica | Q1 | 2N2907 | https://www.communica.co.za/products/2n2907a?variant=20129197686857 | R11,24 | 1 | R11,24
Mantech | Q2, Q3, Q5 | 2N3904 | https://www.mantech.co.za/ProductInfo.aspx?Item=14M3778 | R0,90 | 3 | R2,70
Communica | D8 | Green LED | https://www.communica.co.za/products/l-53cgck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 | R1,90 | 1 | R1,90
Communica | D1, D5 | 6.2V zener | https://www.communica.co.za/products/bzx83c6v2?variant=19952614211657 | R0,58 | 2 | R1,16
Communica | RV2 | 10k potetniometer | https://www.communica.co.za/products/ct6p10k?variant=19886736277577 | R10,81 | 1 | R10,81
Digikey | Q6 | FQP27P06 Mosfet | https://www.digikey.co.za/en/products/detail/onsemi/FQP27P06/965349?s=N4IgTCBcDaIGIEUAKYDsSAMA2EBdAvkA | R40,00 | 1 | R40,00
Communica | SW1 | Pushbutton | https://www.communica.co.za/products/tc0010z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 | R2,28 | 1 | R2,28
Communica | R26 | 100k ohm resistor | https://www.communica.co.za/products/cfr25j-100k?variant=31232749895753 | R0,14 | 1 | R0,14
Communica | Q4 | IRF3205 | https://www.communica.co.za/products/irf3205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 | R19,49 | 1 | R19,49
 |  |  |  |  |  | R85,48
Battery Level Indicator
Communica | D15 | 8.2V zener | https://www.communica.co.za/products/bzx79c8v2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 | R0,44 | 1 | R0,44
Communica | D16 | 9.1V zener | https://www.communica.co.za/products/bzx83c9v1?variant=19952632168521 | R0,58 | 1 | R0,58
Communica | D17 | 11V zener | https://www.communica.co.za/products/bzx83c11v?variant=19952635871305 | R0,58 | 1 | R0,58
Communica | D18 | Red LED | https://www.communica.co.za/products/l-53id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 | R1,96 | 1 | R1,96
Communica | D19 | Yellow LED | https://www.communica.co.za/products/l-53lyd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 | R1,96 | 1 | R1,96
Communica | D20 | Green LED | https://www.communica.co.za/products/l-53cgck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 | R1,90 | 1 | R1,90
Communica | R28, R29, R30 | 1k ohm resistor | https://www.communica.co.za/products/cfr50j-1k0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 | R0,35 | 3 | R1,05
Communica | - | Breadboad | https://www.communica.co.za/products/hkd-d-s-protoboard-7x9cm?variant=31932644163657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 | R17,00 | 1 | R17,00
 |  |  |  |  |  | R25,47
Buck Converter
Communica | U2 | 555 Timer IC | https://www.communica.co.za/products/lm555cn?variant=20129127268425 | R6,04 | 1 | R6,04
Mantech | Q7 | IRFZ44 Mosfet | https://www.mantech.co.za/ProductInfo.aspx?Item=35M9264 | R9,00 | 1 | R9,00
Mantech | U3 | LM7809 IC | https://www.mantech.co.za/ProductInfo.aspx?Item=35M1734 | R6,66 | 1 | R6,66
Communica | D11 | 1N5819 schottky diode | https://www.communica.co.za/products/1n5819?variant=20115572850761 | R0,92 | 1 | R0,92
Mantech | L1 | 330uH inductor | https://www.mantech.co.za/ProductInfo.aspx?Item=72M1444 | R11,27 | 1 | R11,27
Mantech | C6, C7, C5 | 1nF capacitor 50V | https://www.mantech.co.za/ProductInfo.aspx?Item=82M1843 | R0,32 | 3 | R0,96
Mantech | C8 | 10uF Capacitor 50V | https://www.mantech.co.za/ProductInfo.aspx?Item=72M0325 | R0,48 | 1 | R0,48
Communica | RV3, RV4 | 10k pot | https://www.communica.co.za/products/ct6p10k?variant=19886736277577 | R10,81 | 2 | R21,62
Communica | R13 | 220 ohm resistor | https://www.communica.co.za/products/cfr25j-100r?variant=30988641009737 | R0,16 | 1 | R0,16
Communica | D2, D10 | 1N4148 rectifier diode | https://www.communica.co.za/products/1n4004f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 | R0,44 | 2 | R0,88
Mantech | R17 | 47k ohm resistor | https://www.mantech.co.za/ProductInfo.aspx?Item=15M5409-A | R0,33 | 1 | R0,33
Mantech | - | 2Pin terminal block | https://www.mantech.co.za/ProductInfo.aspx?Item=72M1361 | R3,54 | 4 | R14,16
 |  |  |  |  |  | R72,48
3.3V Linear Regulator
Communica | C9 | 0.1uF capacitor | https://www.communica.co.za/products/0-1uf-35vt-5mm?variant=30718441095241 | R3,16 | 1 | R3,16
Communica | U4 | LM317T | https://www.communica.co.za/products/lm317t?variant=31879196901449 | R9,95 | 1 | R9,95
Communica | C10 | 1uF capacitor | https://www.communica.co.za/products/1uf-50vr?variant=20105718169673 | R0,52 | 1 | R0,52
 |  |  |  |  |  | R13,11
Short Circuit Protection
Communica | R21 | 1k ohm resistor | https://www.communica.co.za/products/cfr50j-1k0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 | R0,35 | 1 | R0,35
Communica | R22 | 330 ohm resistor | https://www.communica.co.za/products/cfr25j-330r?variant=31232752975945 | R0,16 | 1 | R0,16
Communica | R23 | 10k ohm resistor | https://www.communica.co.za/products/cfr25j-10k?variant=30986617225289 | R0,16 | 1 | R0,16
Communica | Q8 | BC547 | https://www.communica.co.za/products/bc547b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 | R0,78 | 1 | R0,78
Mantech | Q9 | TIP42 | https://www.mantech.co.za/ProductInfo.aspx?Item=35M1448-C | R11,34 | 1 | R11,34
 |  |  |  |  |  | R0,00
 |  |  |  |  |  | R12,79
Total |  |  |  |  |  | R209,33
