murrayinglis/EEE4113F-Group19/Housing/Pictures/Drawings for extra parts that atttach.png

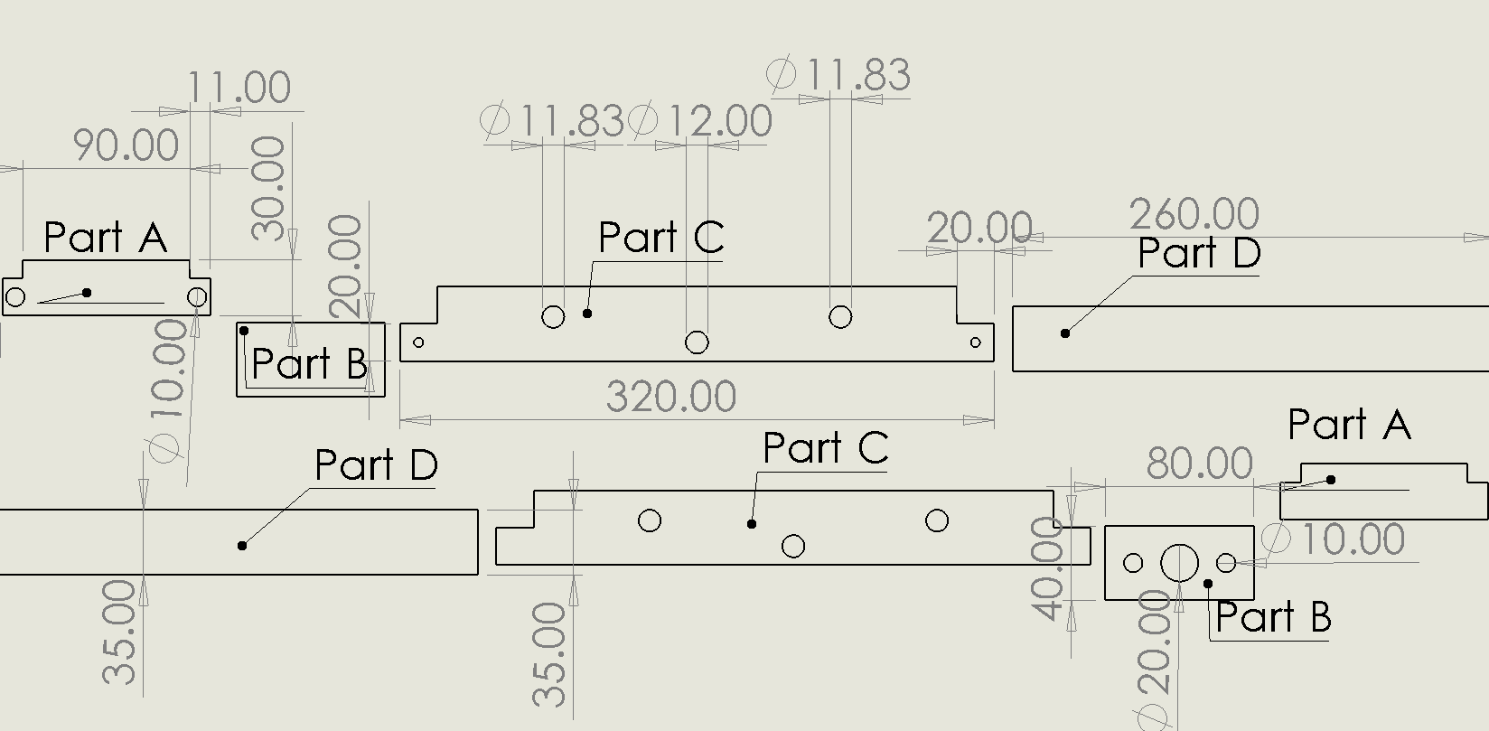
Housing/Pictures/Drawings for extra parts that atttach.png
