murrayinglis/EEE4113F-Group19/Housing/Assem2.SLDASM

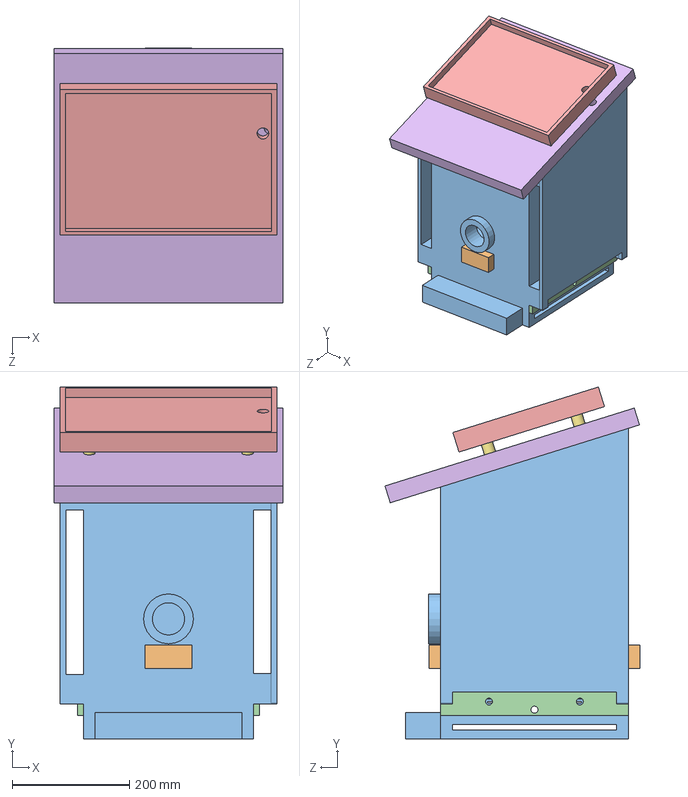
[picture p41: CAD file, 2024-05-12]
Housing/Assem2.SLDASM
390.0 x 600.0 x 434.9 mm
Design Nest Box version 2
cover
Casing of Solar panel
Lid
Lid poles x 4
Cover of temp sensor on outside x 2
Temp Sensor Holder x 4
