murrayinglis/EEE4113F-Group19/Housing/Assem1.SLDASM

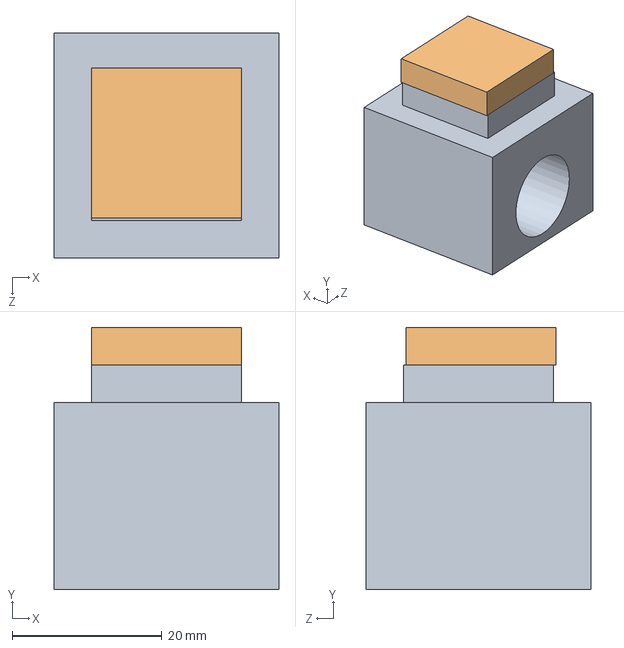
[picture p42: CAD file, 2024-05-12]
Housing/Assem1.SLDASM
30.0 x 35.0 x 30.0 mm
Temp Sensor Holder
Lid of holder for temp sensor
