murrayinglis/EEE4113F-Group19/Housing/All extra parts drawing.SLDASM

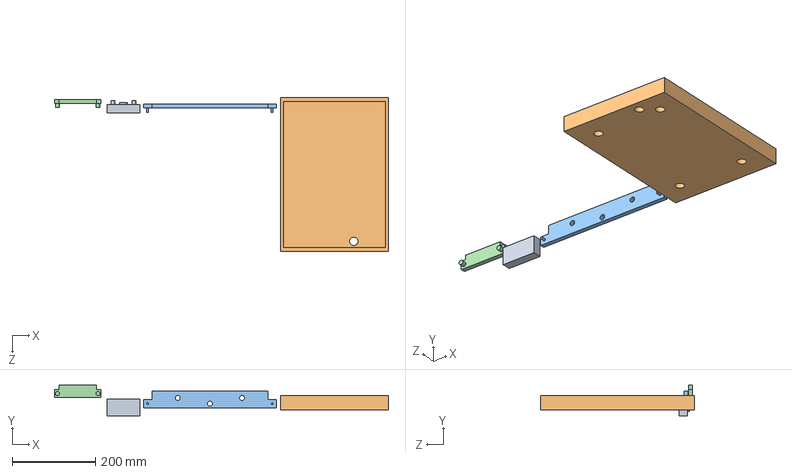
[picture p43: CAD file, 2024-05-12]
Housing/All extra parts drawing.SLDASM
804.3 x 73.5 x 370.0 mm
Cover of temp sensor on outside
Casing of Solar panel
cover
Cover for Electronic compartments
