murrayinglis/EEE4113F-Group19/Housing/Holder for 90cm cable.SLDPRT

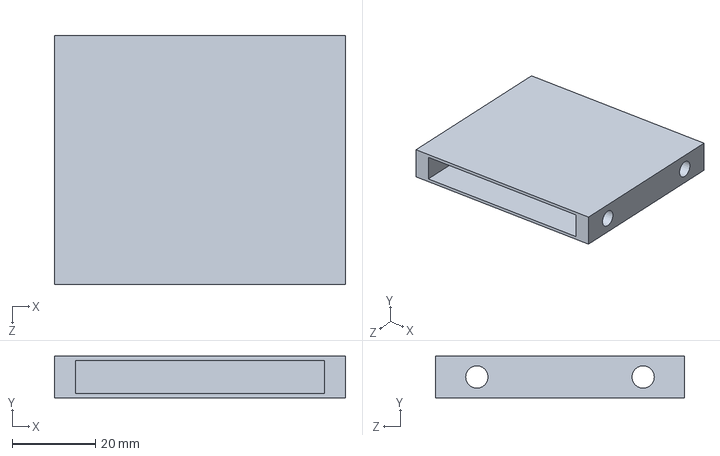
[picture p44: CAD file, 2024-05-12]
Housing/Holder for 90cm cable.SLDPRT
70.0 x 10.0 x 60.0 mm
