murrayinglis/EEE4113F-Group19/Housing/Lid poles.SLDPRT

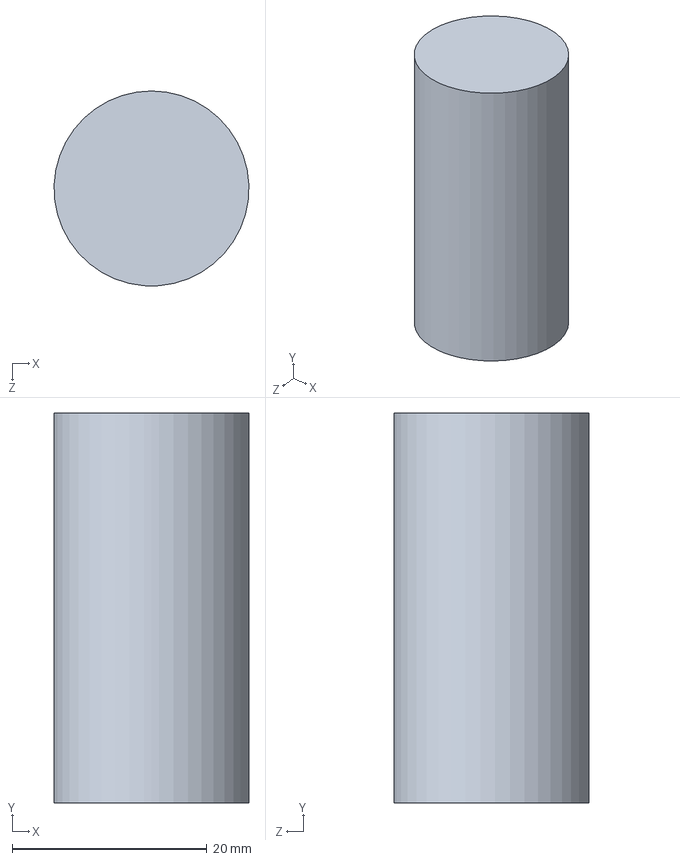
[picture p45: CAD file, 2024-05-12]
Housing/Lid poles.SLDPRT
20.0 x 40.0 x 20.0 mm
