murrayinglis/EEE4113F-Group19/Housing/cover.SLDPRT

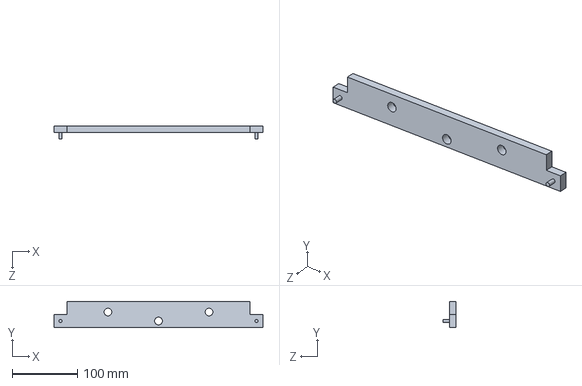
[picture p46: CAD file, 2024-05-12]
Housing/cover.SLDPRT
320.0 x 40.0 x 20.0 mm
