murrayinglis/EEE4113F-Group19/Housing/Temp Sensor Holder.SLDPRT

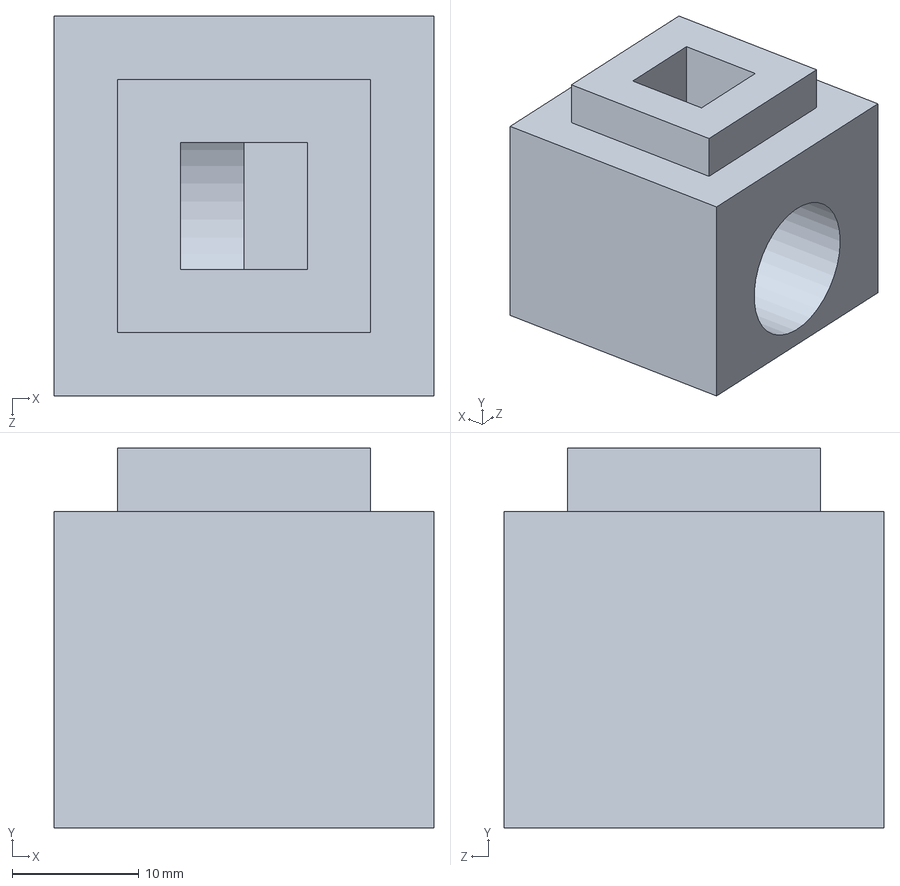
[picture p47: CAD file, 2024-05-12]
Housing/Temp Sensor Holder.SLDPRT
30.0 x 30.0 x 30.0 mm
