murrayinglis/EEE4113F-Group19/Housing/Electronic compartment.SLDPRT

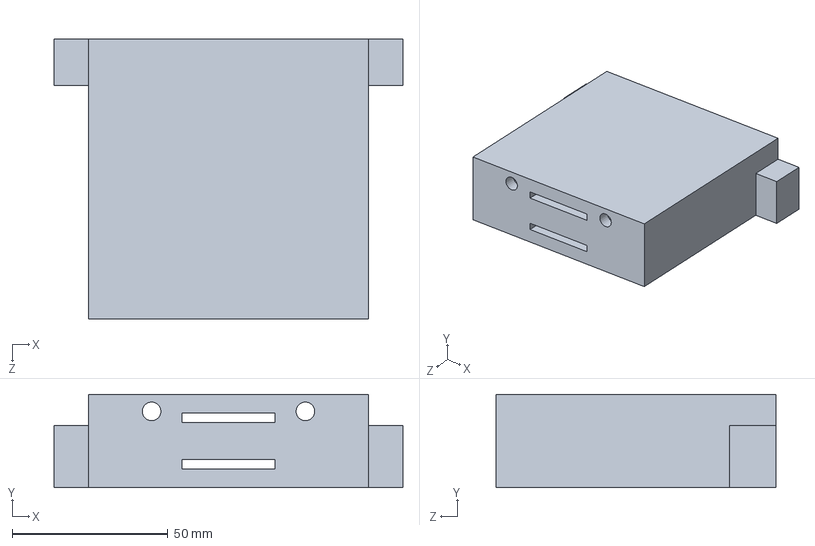
[picture p48: CAD file, 2024-05-12]
Housing/Electronic compartment.SLDPRT
112.0 x 30.0 x 90.0 mm
