murrayinglis/EEE4113F-Group19/Housing/Cover for Electronic compartments.SLDPRT

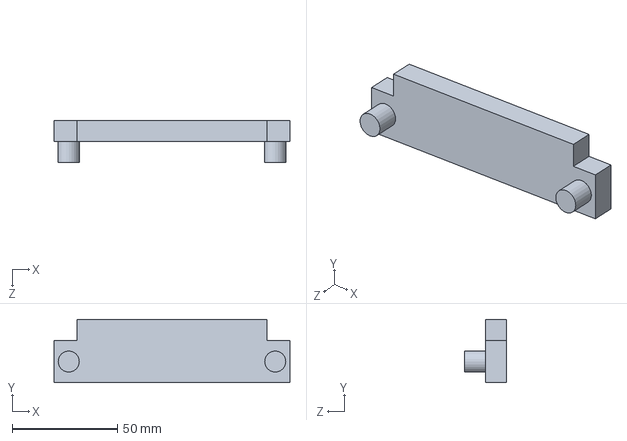
[picture p49: CAD file, 2024-05-12]
Housing/Cover for Electronic compartments.SLDPRT
112.0 x 30.0 x 20.0 mm
