murrayinglis/EEE4113F-Group19/Housing/Cover of temp sensor on outside.SLDPRT

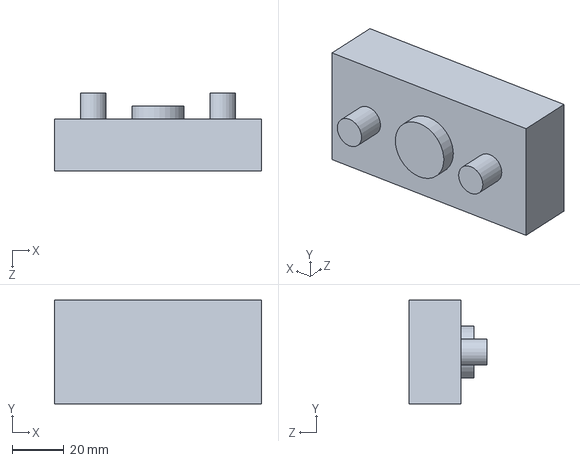
[picture p50: CAD file, 2024-05-12]
Housing/Cover of temp sensor on outside.SLDPRT
80.0 x 40.0 x 30.0 mm
