murrayinglis/EEE4113F-Group19/Housing/Lid.SLDPRT

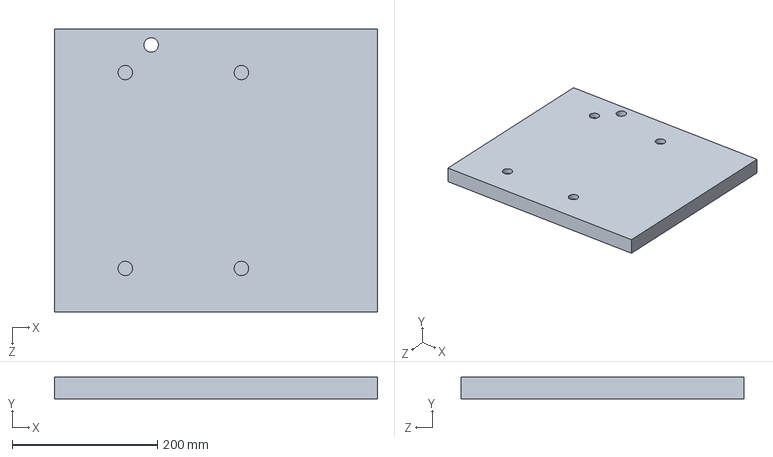
[picture p51: CAD file, 2024-05-12]
Housing/Lid.SLDPRT
445.3 x 30.0 x 390.0 mm
