murrayinglis/EEE4113F-Group19/(list of files, cad)

Other CAD files:
Housing/Temp holder with lid in assembly.SLDASM
Housing/All extra parts drawing.SLDDRW
Housing/Assem2.SLDDRW
Housing/Drawing of Enclosure Box.SLDDRW
Housing/Electronic compartment.STL
